dlgur1994/Purdue2019/README.md

# AgIoT_LoRa_vs_APRS
CIT 581 IoT Fall 2019

Semester project overview: Build a system to monitor a remote power generation station (solar and wind) and orchard for a “farmer” who lives 30 miles away.

Background: Agricultural IoT is one of the most promising and potentially important areas of the IoT market.  It is also an excellent way to study the IoT ecosystem while making important contributions to a field of research that is critical to our world; food and raw materials production.  Purdue’s CIT Department has had several successful projects in this area, and there are numerous companies and organizations in Central Indiana (such as WHIN) putting large amount of resources into Ag IoT systems.  

Project specifics: Our scenario will be that of a small orchard located about 30 miles from the “farmer”, who needs to monitor and receive pertinent data regarding fruit production, as well as monitoring the available alternative energy sources used to power irrigation, lighting and the IoT systems used for the project. The plan is to build an IoT system for a “Micro-Farm of the Future”.  Emphasis will be placed on the user interface and analytics that can quickly update the farmer on specific information that he needs to manage the farm and systems.  The specific sectors and topics that will be explored are as follows:
1.	Soil conditions:  The mainstay of farming, being able to get important information about moisture, temperature, pH, and other factors over a large geographic area is critical to successful yields.
2.	Weather information:  As important as soil conditions, weather information and outlook can make or break a year’s harvest.
3.	Alternative energy:  Many areas of agricultural land in the U.S. do not have easy access to electrical power.  An alternate power supply consisting of solar panels and a wind generator has already been built, but ways of monitoring key elements of the station for providing electrical power to irrigation, lighting as well as IoT and network equipment will need to be implemented.
4.	Radio Networks:  There are numerous LPWAN, as well as higher throughput networks (such as LTE), that we will need to evaluate and implement.  A parallel project with a group of students from the IITP sponsored program at the K-SW Square using the amateur radio (HAM) APRS frequencies as a no-cost network backbone will continue to be tested.
5.	Security:  Both Physical and Cyber Security systems must be considered. Of priority for the farmer is monitoring power and technology resources, implementing means of loss prevention, as well as pest and varmint detection and deterrence.

For Next Wednesday:
You are a small IoT integration company that is interested in completing the above described system for Farmer Smith, and if successful, possibly commercializing the system as a turn-key for other small farms. You have an interview with the customer Wednesday the 28th during the scheduled CIT 581 IoT class period.  What would you need to know if you were a vendor trying to put together a solution for this customer and have an acceptable ROI on the project?  Put together a list of questions to ask during the interview.

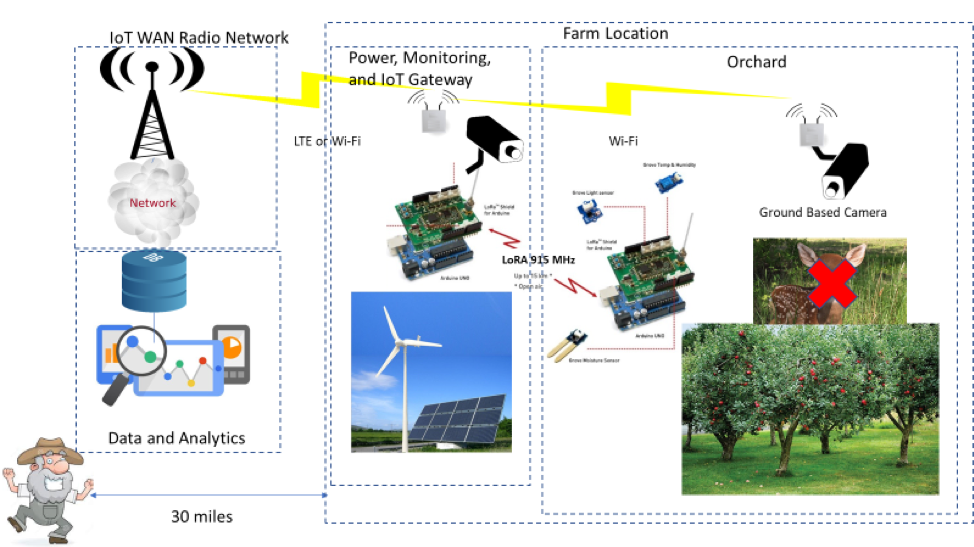
[picture p1: images/project_description.png]
ProjectDescription
