dlgur1994/Purdue2019/Records/Solenoid valve.docx

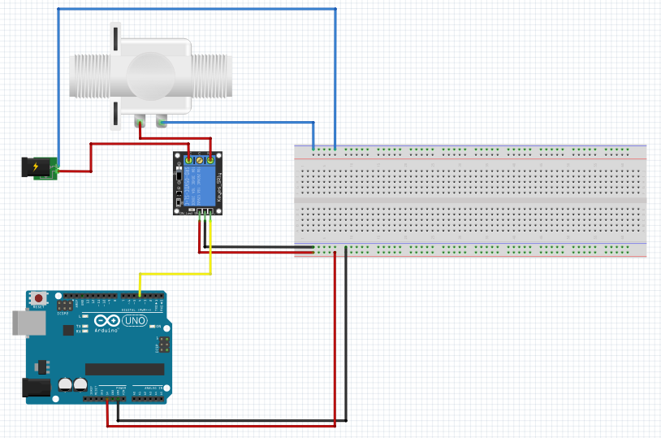
[picture p12: figure]

solenoid valve with external power supply
