dlgur1994/Purdue2019/LoRa/MQTT/LoRa_Web/LoRa Smart farm Web.docx

https://github.com/agiot2019-lora/lora-mqtt_smart_farm

여러분 저희 서비스 이름 멀로 할까여..? 그래도 이름은 있어야하지 않겠나..ㅎ

우선 Smart Farm 으로 둘게욤 -미란

Function:

1. Soil Moisture
2. Temperature
3. Humidity
4. Weather
5. Actuator Turn On/Off

DB structure

users(Farmer):

- user_id
- user_pw
- user_contact
- user_name

farms:

-farm_id

-farm_name

-farm_location

-user_id

soil_moisture:

-soil_moisture_id

- s_datetime
- soil_moisture
- farm_id

sensors:

-farm_id

- temperature
- weather
- Humidity
- Actuator (boolean true: on, false: off)
