dlgur1994/Purdue2019/Records/Papers/LoRa/Paper List.docx

1. “Smart Agriculture Solution using LoRa and IoT”

# 2. LoRa Based Smart Irrigation System

# 3. Smart Farm Monitoring Using LoRa Enabled IoT

# 4. A Practical Marine Wireless Sensor Network Monitoring System Based on LoRa and MQTT

5. Comparison of LoRa 915 MHz and 433 MHz on Distance Coverage in Thailand Area
