dlgur1994/Purdue2019/Records/Papers/Literature Review Matrix.xlsx

Authors | Title | Link | Year | Source title | Document Type
Kemal Hajdarevic, Samim Konjicija, Abdulhamit Subasi | A Low Energy APRS-IS Client-Server Infrastructure Implementation using Raspberry Pi | https://www.researchgate.net/publication/268100793_A_Low_Energy_APRS-IS_Client-Server_Infrastructure_Implementation_using_Raspberry_Pi | Nov. 2014 |  | PDF
Nayyar Anand, Puri Vikram | Smart farming: IoT based smart sensors agriculture stick for live temperature and moisture monitoring using Arduino, cloud computing & solar technology. | https://www.researchgate.net/publication/313804002_Smart_farming_IoT_based_smart_sensors_agriculture_stick_for_live_temperature_and_moisture_monitoring_using_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 | 2016 |  | PDF
