dlgur1994/Purdue2019/Forums/LoRa IoT Forums.docx

https://www.skyhook.com/blog/iot/internet-of-things-events

http://www.wikicfp.com/cfp/call?conference=internet%20of%20things

1. https://coinsconf.com/

(IEEE Coins, Barcelona Spain July 27-29 , Deadline: Mar 6, 2020)

Track Name: IoT-driven Smart Agriculture

A) Technologies, techniques and architectures

2. http://www.upiot.org/ (UPIOT, IEEE Shanghai)
3. https://iot-conference.org/iot2020/ (6-9 OCT 2020)
