dlgur1994/Purdue2019/Records/Run Top block.docx

파일 위치

~/yun/gr-APRS/Examples/top_block.py

이전 팀 최종 블럭

/home/sdr/yun/gr-APRS/Examples/APRS_RX_RTL
