dlgur1994/Purdue2019/Circuit/APRS_Arduino_circuit.PNG

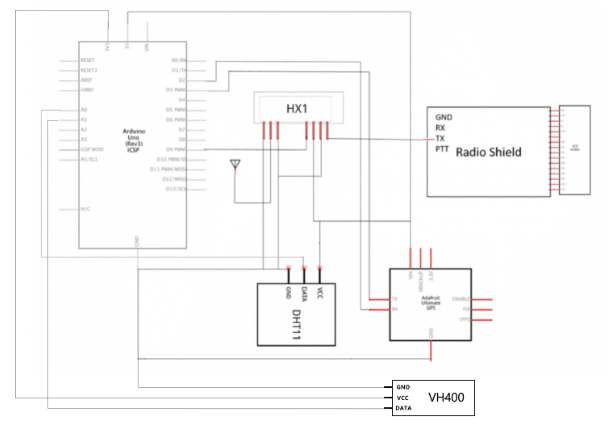
Circuit/APRS_Arduino_circuit.PNG
