dlgur1994/Purdue2019/LoRa/MQTT/LoRa_Sensor/써킷2.png

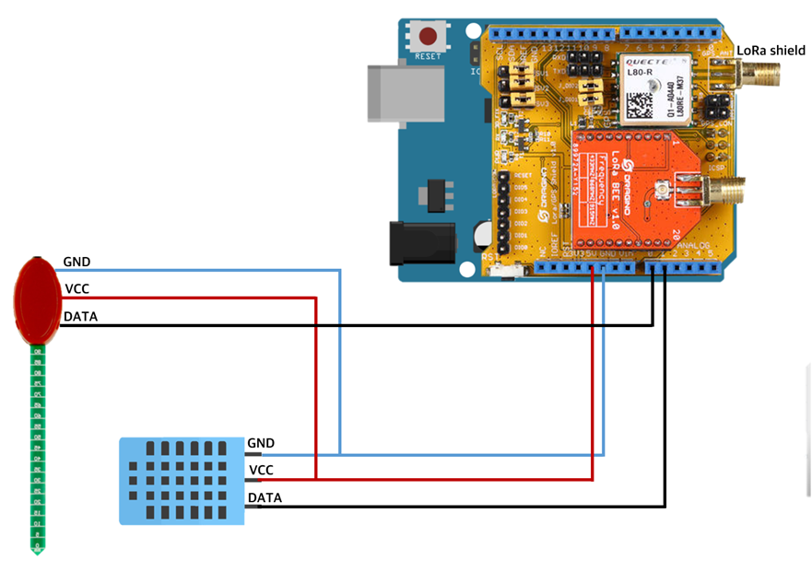
LoRa/MQTT/LoRa_Sensor/써킷2.png
