dlgur1994/Purdue2019/LoRa/MQTT/LoRa_Solenoid/solenoid_circit.png

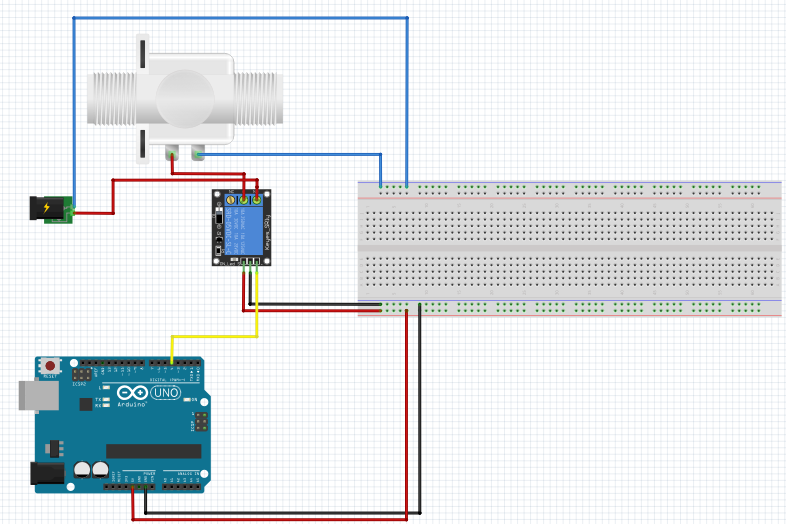
LoRa/MQTT/LoRa_Solenoid/solenoid_circit.png
