dlgur1994/Purdue2019/LoRa/MQTT/캡처.PNG

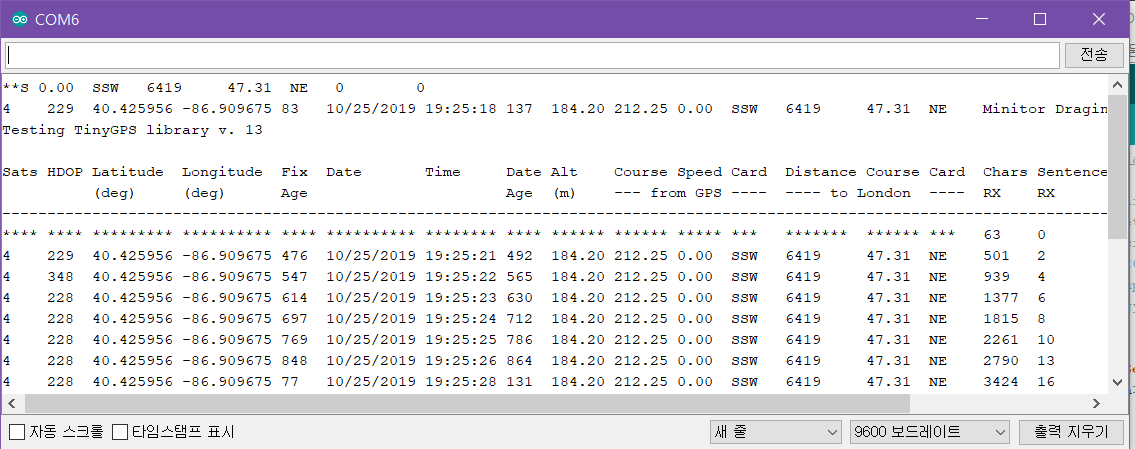
LoRa/MQTT/캡처.PNG
