dlgur1994/Purdue2019/Papers/LoRa/Flowchart-Page-3.png

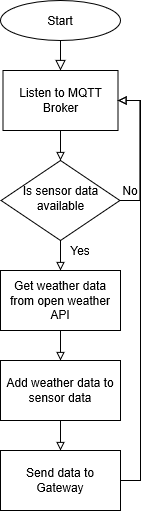
Papers/LoRa/Flowchart-Page-3.png
