dlgur1994/Purdue2019/Papers/LoRa/LoRa Diagram.png

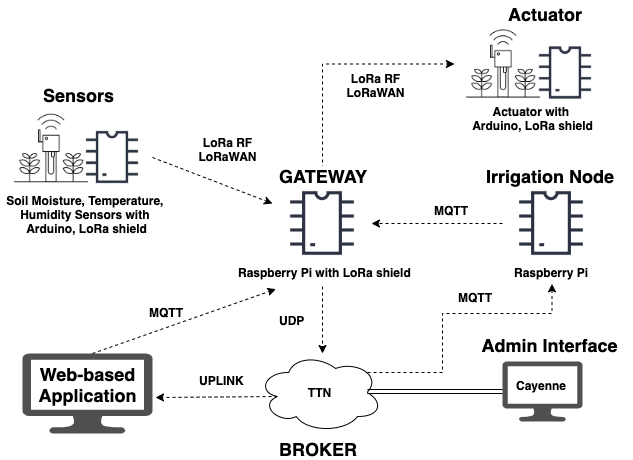
Papers/LoRa/LoRa Diagram.png
