dlgur1994/Purdue2019/Papers/LoRa vs APRS/making/비교논문 (2020-1 ver).docx

빨간 글씨 : 추가한 부분

빨간 공백 : 띄어쓰기 한 부분

빨간 취소선 : 글자 지운 부분 (괄호로 ‘00지운거’ 써놓음)

노란색 형광 : grammarly에서는 추가하라고 나오는데 확실치가 않은부분

파란색 형광 : grammarly에서 삭제 추천

초록색 형광 : grammarly에서 변경 추천

Title

Feasibility of Networking Technology for the Smart Farm : LoRa vs APRS

Abstract

Smart Farms and IoT (Internet of Things) have an inseparable relationship. Sensors, gateways, servers, databases, web-based applications, are all connected to smart farms. Hence, the decision of networking technology is very vital when running a smart farm. LoRa (Long Range) has been the most suggested candidate for smart farms. Theoretically, APRS (Automatic Packet Reporting System) can communicate far more distance than LoRa. However, there are no existing studies that implemented APRS in the smart farm IoT system. Therefore, this study tests and compares the distance coverage of LoRa and APRS networking technologies in the Purdue Agronomy Center for Research and Education. The results were evident that LoRa is more feasible than using APRS in the smart farm IoT system.

Introduction

With the fourth industrial revolution and the advancement of IoT technology, ICT (Information and Communication Technologies) has been integrated into agriculture and increased not only the quantity and quality of products but also convenience for the farmers. In IoT-based smart farming, data from weather conditions, light, soil moisture or crop’s growth progress is collected by IoT device sensors. With the data, farmers can monitor the field conditions from anywhere with smart devices. Also, irrigation systems are automated so that the water will be used more efficiently and the yields will be improved. In recent years, research on solutions to increase the performance and productivity of the smart farm while lowering the cost has become very popular. Previous studies like \cite{b1} show~~s~~(s지운거) that the main technologies of IoT based smart farming are network technologies, security, and IoT agriculture applications.

To be more specific with the networks, there are numerous network technologies for wireless connection of the sensors and actuators for IoT. The network technologies focus on providing scalability, extended coverage, low cost, and energy efficiency for the end-user devices \cite{b2}. Since the IoT agricultural network helps to monitor agriculture data and facilitate the transmission and reception of agriculture data, it is one of the vital elements of IoT in agriculture \cite{b1}.

Although many kinds of research~~es~~(es지운거) focus on implementing an IoT system with suitable communication network for smart farming, little attention has been given to comparing communication systems to decide the better network technology. Therefore, this study focuses on two network technologies, LoRa and APRS, for the smart farm IoT system. The objective of this paper is to question the feasibility of LoRa and APRS in the smart farm IoT system and to propose a better network technology that is more suitable for a smart farm. In this paper, we experiment with the distance coverage of the LoRa network and the APRS network at Purdue Agronomy Center for Research and Education.

Related work

This section discusses the existing IoT communication protocols, explaining why we particularly chose LoRa and APRS for this study.

LoRa

As this study focuses on IoT devices for smart farms, protocol selection was made within Low-Power Wide Area Networks (LPWANs). Two main factors should be considered when developing smart farm IoT devices: 1) wide area coverage; 2) long battery life. Therefore, short-range communication protocols like Bluetooth or ZigBee are not likely used for IoT devices that require long-range communication and wide area coverage. LPWAN, on the other hand, provides long-range connections with low data transmission rates\cite{b10}. Hence, LPWAN should be used for low power IoT devices that transmit a small amount of data and require battery efficiency\cite{b11}. Smart farm IoT devices suite these descriptions; comparatively small data collected by sensors transmitted for long-range communication.

LoRa, NB-IoT, Sigfox, Weightless are some of the leading LPWAN technologies. This study specifically tests LoRa as it is known to provide long-range communication, the long battery life on a low budget\cite{b12}. LoRa’s advantages are ~~evidently~~ shown in many studies. Ji et al.\cite{b13} successfully transmitted image data using LoRa technology. Kodali et al.\cite{b14} was (were) able to implement an irrigation system in a smart farm through a web interface.

APRS

Automatic Packet Reporting System (APRS), also known as ‘amateur radio’ or ‘ham radio’, was designed by Bob Bruninga about 25 years ago. APRS enables real-time information exchange between multiple nodes and processed data are visualized on APRS-Internet Service (APRS-IS) websites as the APRS infrastructure\cite{b15,b16}. APRS is transmitted on a shared local VHF frequency, depending on the country. North America uses 144.39 MHz. Although APRS was designed for large local areas, easy ~~digipeating~~~~(이런 단어가 없음)~~ repeating with callsigns allows fast global communications\cite{b17}. Due to these characteristics, APRS has been used for real-time tactical, emergent situations.

There are many attempts like Hajdarevic et al.\cite{b16} on building low-cost, low-energy APRS transceivers on microcontrollers or single-board computers such as Arduino and Raspberry Pi. Despite the increasing interest in building low-cost APRS transceivers and APRS' characteristics suitable for IoT devices, ~~there was no research that~~ ~~solely~~ ~~used~~ (no research solely used) or tested APRS as an IoT communication protocol. This raised the question of why APRS is not applied in the IoT field. Therefore, this study ultimately aims to answer the question of the feasibility of APRS for long-range IoT device communications.

Approach → trial and error 같은 느낌

여기 내용 추가

APRS 처음 셋업할때 이야기들…

- 우리가 값이 제대로 안나와서 간이 테스트를 하게 되었다.
- 제대로 실험하기 전에 했던 간이 테스트
  - transmit power를 높이는 방법
    - 얇은 케이블 -> 50옴 케이블
  - receive power를 높이는 방법
    - 안테나 접지
    - 안테나 높이
    - 안테나 방향 맞추기
- 이 결과 원하는 값이 나오게 되었고 이를 토대로 제대로 된 실험들을 진행하게 되었다.

Results

For the feasibility test of LoRa and APRS, we have conducted several tests outside at the Purdue Agronomy Center for Research and Education. This section mentions the test environments, multiple test results, and result evaluation for the distance coverage comparison of LoRa and APRS.

Test Environment

The distance comparison test between LoRa and APRS was conducted at the Purdue Agronomy Center for Research and Education. The tests were conducted by placing the receiving antenna at the weather station of the Purdue Agronomy Center. The receiving antenna of LoRa and the receiving antenna of APRS were installed on ~~a~~ (the) same bar, but ~~on~~ different height. The receiving antenna of LoRa was 4.0 meters high from the ground, 6.4 meters high for APRS. Transmitters were on the move, checking if the data were properly received at the receiving end, the weather station. Both transmitters ~~were~~ (was) carried in a car, and the antenna of APRS were securely attached to the roof of the car, while LoRa’s antenna was held at the same height as the transmitting antenna of APRS, 2.35 m. The location of the transmitting points were all saved on Google Maps, which was later used to calculate the distance from the weather station to the transmitter. To minimize radio interference during testing, LoRa and APRS were tested alternately. Also, cell phone calls were banned and at least 30 seconds of waiting time ~~was~~ (were) ensured to prevent possible errors due to the movement of the transmitters. If the data were consecutively received, the transmitters were moved forward for further distance. If not, the transmitters moved back to shorten the distance. This process was repeated to find the last transmitting point where data were successfully transmitted. All of the following distance results were derived by calculating the distance between the weather station and the last transmitting point using Google Maps.

Tests

Table 1 shows the overall distance coverage results from each test~~s~~(s지운거) while Table 1 and 2 shows the antenna specifications for LoRa and APRS.

1st test

The transmitter and receiver of LoRa consist of Arduino and LoRa Shield v1.4. The antenna gain for ~~the~~(the 지운거) both transmitting and receiving ends are 2.14 dBi. Both antennas were held by a hand on about 1 m above ground. The output power of the transmitter antenna measured by the spectrum analyzer was 16 dBm. Due to weather conditions, the receiver antenna was inside the weather station. The maximum distance coverage was 160 m.

<tables>

APRS used Arduino and HX1 transmitter while the antenna was connected using jumper cables. Software Defined Radio (SDR), powered by a laptop and an antenna was used as the receiver for APRS. The gain of the transmitter antenna for APRS was 2.14 dBi, where the output power was 15 dBm. For the receiver, the antenna gain was 6 dBi. At that time, the maximum distance was 1.3 km. Transmitting and receiving conditions were generally good, although some of the data were missed from time to time.

2nd test

LoRa changed both the transmitter and receiver antenna. Previously, the antenna gain for both antennas ~~were~~ (was) 2.14 dBi. With the new antennas, the transmitter antenna had 9 dBi gain and the receiver antenna had 6 dBi gain. The transmitter antenna was attached ~~on~~ (to) the car roof at about 1.8 meters above the ground. With the new antenna specifications, LoRa was able to cover 4.2 km, successfully receiving data.

For APRS, the setup for both sides ~~were~~ (was) the same as before, except for a transistor. A transistor was added to amplify the output power of the transmitter. While the transmitter antenna gain was identical to 2.14 dBi, the output power increased to 20 dBm by using the transistor. Two tests were conducted on this second test: 1) without transistor; 2) with the transistor. APRS covered 670 m without using the transistor, while it covered 700 m using the transistor. The result was significantly different ~~to~~ (from) the first test due to the open circuit problem inside the antenna.

Final test

To reduce the signal attenuation in the APRS circuit system, 50-ohm cable was used instead of the jumper cable to connect HX1 and the transmitter antenna.

<tables>

By doing so, the output signal from the HX1 got stronger, and the transmitting power measured by the spectrum analyzer was 24 dBm without the transistor. Since HX1 can handle signal power up to 24.7 dBm, the transistor was removed from the circuit. APRS also changed the transmitter antenna after the second test. The new transmitter antenna had 1.17 dBi gain. With the newly alternated APRS circuit and antenna, APRS was able to cover 0.86 km.

LoRa used identical specifications for the entire transmitter, receiver system. The results were also ~~identical~~ identified as the second test, covering 4.2 km as shown in Fig. 1.

Final setup

Table 3 lists all the hardware that ~~were~~ (was) used to build the transmitter and receiver system for LoRa and APRS.

LoRa

To facilitate the use of the LoRa network, LoRa/GPS shield attachable to the Arduino was used. The antennas used for both transmitter and receiver supported 915MHz, which is the LoRa frequency in North America. Transmitter antenna and receiver antenna had 9 dBi and 6 dBi gain. The output power of the transmit antenna measured by the spectrum analyzer was 16 dBm.

APRS

Arduino Uno and HX1 chip ~~was~~ (were) used to transmit APRS packets at 144.390MHz. Since the lack of a radio shield for APRS, HX1 was directly controlled to transmit power efficiently. The transmitter antenna was suitable for 144-148 MHz frequency, with 1.17 dBi gain. The transmitter antenna’s output power measured by the spectrum analyzer was 24 dBm. 50-ohm cable was used to connect the antenna and the HX1 transmitter to amplify the output power. To receive APRS data packets, GNU radio was used with USRP b200 on Ubuntu. The receiver antenna had 6 dBi gain.

Test evaluation

With the antenna specifications that were used for the final test, the Friis transmission formula was used to review the final distance coverage results:

<equations>

“The Friis Transmission formula is a basic equation used to calculate the received power of a basic receiver at a fixed distance from a transmitting system.”\cite{b18}

According to the Friis Transmission formula, theoretically, APRS should have covered a longer distance than LoRa as shown in Table 5. However, according to the final results, APRS distance was much shorter than LoRa. ~~In order to~~ (To) understand the reasoning of the final test results, the Fresnel Zone Radius was calculated.

The definition of Fresnel Zone is the size of the elliptically-shaped area of RF propagation between a transmit and receive antenna.

“Objects within the area of the Fresnel zone can reflect radio waves and induce multi-path propagation issues between the transmitter and receiver, where direct path line-of-sight radio waves and the reflected path radio waves are received out of phase from one another.” \cite{b19}

Therefore, ~~in order to~~ (to) have no interference, it is important to have no obstacles in the Fresnel Zone. This zone could be calculated by a Fresnel Zone Calculator:

<equations>

The antennas must be located within the 80\% of the radius obtained through the Fresnel Zone Calculator, shown in Table 5, for seamless communication.

The result of the Fresnel Zone Radius indicated that ~~in order to~~ (to)communicate around the theoretical 59.7 km, the theoretical distance, away using APRS, the antennas for both transceiver and receiver antenna must be at least 140m above the ground. However, the testing for the antennas ~~were~~ (was) installed approximately 4.0 m above the ground.

Additionally, ~~in order to~~ (to) calculate the efficiency constrained by height, the tested distance was divided by the theoretical distance. LoRa was 45.16\%, while APRS was 1.44\%, as shown in Table 5.

Conclusion

This study was proposed to determine whether LoRa or APRS is more adequate for the networking technology in Smart Farms. The location of the experiment for the distance coverage of both networks was at Purdue Agronomy Center for Research and Education. According to the test results, LoRa’s final distance coverage was 4.2 km, when the transmitter gain was 9 dBi and the receiver gain was 6 dBi. While APRS distance coverage was 0.84 km, with 1.17 dBi of transmitter gain and 6 dBi of receiver gain.

The efficiency constrained by height from the final test results was 45.16\% for LoRa and 1.44\% for APRS.

<table>

Both of the estimated antenna installation heights calculated from the Fresnel Zone Radius are high altitudes, which the majority of the smart farm system cannot meet the circumstances. When comparing the installation possibility of the two networking technologies, LoRa’s theoretical distance was more achievable than APRS. Therefore, the result indicates that LoRa is more feasible than APRS for ~~the~~ networking technology in smart farms.

However, there are limitations to our test experiment. First, the antenna specification was different for LoRa and APRS. Even though, we used two antennas that had the same dBi of 3, when running the frequency (APRS frequency) for the APRS the dBi was measured to be 1.17 dBi. Second, the testing was done after the corns were all harvested. Hence, there could be different results when there are obstacles between the transceiver and receiver antennas.

Future testing will be done by using the same antennas gains for LoRa and APRS. Also, the transmitter and receiver antennas will be installed at much higher altitudes.

References
