dlgur1994/Purdue2019/Papers/LoRa vs APRS/making/비교논문 (2020-3 ver).docx

빨간 글씨 : 추가한 부분

빨간 공백 : 띄어쓰기 한 부분

빨간 취소선 : 글자 지운 부분 (괄호로 ‘00지운거’ 써놓음)

노란색 형광 : grammarly에서는 추가하라고 나오는데 확실치가 않은부분

파란색 형광 : grammarly에서 삭제 추천

초록색 형광 : grammarly에서 변경 추천

Title

Feasibility of Networking Technology for Smart Farms: LoRa vs APRS

Abstract

Smart Farms and IoT (Internet of Things) have an inseparable relationship. Sensors, gateways, servers, databases, web-based applications, are all connected to smart farms. Hence, the decision of networking technology is very vital when running a smart farm. LoRa (Long Range) has been the most suggested candidate for smart farms. Theoretically, APRS (Automatic Packet Reporting System) can communicate far more distance than LoRa. However, there were no existing studies that implemented APRS in the smart farm IoT system. Therefore, this study tests and compares the distance coverage of LoRa and APRS networking technologies in the Purdue Agronomy Center for Research and Education. The results were evident that LoRa is more feasible than using APRS in the smart farm IoT system.

Introduction

With the fourth industrial revolution and the advancement of IoT technology, ICT (Information and Communication Technologies) has been integrated into agriculture and increased not only the quantity and quality of products but also convenience for the farmers. In IoT-based smart farming, data from weather conditions, light, soil moisture or crop’s growth progress is collected by IoT device sensors. With the data, farmers can monitor the field conditions from anywhere with smart devices. Also, irrigation systems are automated so that the water will be used more efficiently and the yields will be improved. In recent years, research on solutions to increase the performance and productivity of the smart farm while lowering the cost has become very popular. Previous studies like \cite{b1} show that the main technologies of IoT based smart farming are network technologies, security, and IoT agriculture applications.

To be more specific with the networks, there are numerous network technologies for wireless connection of the sensors and actuators for IoT. The network technologies focus on providing scalability, extended coverage, low cost, and energy efficiency for the end-user devices \cite{b2}. Since the IoT agricultural network helps to monitor agriculture data and facilitate the transmission and reception of agriculture data, it is one of the vital elements of IoT in agriculture \cite{b1}.

Although a lot of research focus on implementing an IoT system with a suitable communication network for smart farming, little attention has been given to comparing communication systems to decide the better network technology. Therefore, this study focuses on two network technologies, LoRa and APRS, for the smart farm IoT system. The objective of this paper is to question the feasibility of LoRa and APRS in the smart farm IoT system and to propose a better network technology that is more suitable for a smart farm. In this paper, we experiment the distance coverage of LoRa and APRS at the Purdue Agronomy Center for Research and Education.

Related work

This section discusses the existing IoT communication protocols, explaining why we particularly chose LoRa and APRS for this study.

LoRa

As this study focuses on IoT devices for smart farms, protocol selection was made within Low-Power Wide Area Networks (LPWANs). Two main factors should be considered when developing smart farm IoT devices: 1) wide area coverage; 2) long battery life. Therefore, short-range communication protocols like Bluetooth or ZigBee are not likely used for IoT devices that require long-range communication and wide area coverage. LPWAN, on the other hand, provides long-range connections with low data transmission rates\cite{b10}. Hence, LPWAN should be used for low power IoT devices that transmit a small amount of data and require battery efficiency\cite{b11}. Smart farm IoT devices suite these descriptions~~;~~ comparatively small data collected by sensors transmitted for long-range communication.

LoRa, NB-IoT, Sigfox, Weightless are some of the leading LPWAN technologies. This study specifically tests LoRa as it is known to provide long-range communication and long battery life on a low budget\cite{b12}. LoRa’s advantages are shown in many studies. Ji et al.\cite{b13} successfully transmitted image data using LoRa technology. Kodali et al.\cite{b14} implemented an irrigation system in a smart farm through a web interface.

APRS

Automatic Packet Reporting System (APRS), also known as ‘amateur radio’ or ‘ham radio’, was designed by Bob Bruninga about 25 years ago. APRS enables real-time information exchange between multiple nodes and processed data are visualized on APRS-Internet Service (APRS-IS) websites as the APRS infrastructure\cite{b15,b16}. APRS is transmitted on a shared local VHF frequency, depending on the country. North America uses 144.39 MHz. Although APRS was designed for large local areas, easy digital repeating with callsigns allows fast global communications\cite{b17}. Due to these characteristics, APRS has been used for real-time tactical, emergent situations.

There are many attempts like Hajdarevic et al.\cite{b16} on building low-cost, low-energy APRS transceivers on microcontrollers or single-board computers such as Arduino and Raspberry Pi. Despite the increasing interest in building low-cost APRS transceivers and APRS' characteristics suitable for IoT devices, there was no research that solely used or tested APRS as an IoT communication protocol. This raised the question of why APRS is not applied in the IoT field. Therefore, this study ultimately aims to answer the question of the feasibility of APRS for long-range IoT device communications.

Approach

At first, we didn't know the characteristics of the antenna properly, so we didn't get the results right and we did a lot of trials and some tests to get the results we wanted. (처음에 우리가 안테나의 특성을 제대로 알지 못하여 결과값이 제대로 안나왔고 원하는 결과값을 얻기 위한 많은 시도와 간이 테스트를 진행했다. )

Both LoRa and APRS had problems with too short a communication distance between the transmitter and the receiver. LoRa had a problem with the code, so after modifying LoRa's TX power to 13, signal bandwidth to 125E3, and coding rate to 5 using the LoRa Arduino API, the existing communication range increased from 100m to 1km. (LoRa와 APRS 둘 다 transmitter와 receiver의 통신 거리가 너무 짧은 문제가 있었다. LoRa는 코드에 문제가 있어서 LoRa Arduino API를 이용하여 LoRa의 TX power를 13, signal bandwidth를 125E3, 그리고 coding rate을 5로 수정을 하고 나니 기존의 통신거리 100m에서 1km까지 늘어났다.)

At first, we weren’t aware of the antenna’s characteristics, so the results were very different from our expectations. In order to minimize any errors, many attempts were made .

Both LoRa and APRS communication distance results were too short compared to theoretical results. After modifying LoRa’s transmitter and receiver code by LoRa’s TX power to 13, signal bandwidth to 125E3, and coding rate to 5 using LoRa Arduino API, the communication range results increased from 100m to 1km.

<로라 통신 거리 증가한 것 보여주는 비교 사진>

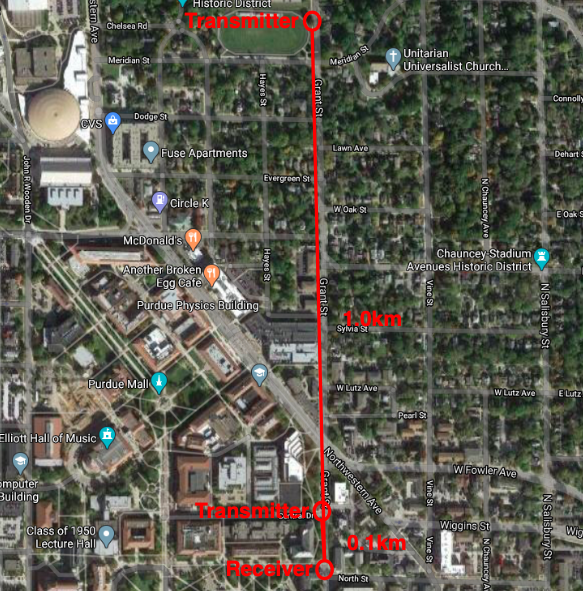
[picture p31: figure]

We recognized that the short communication distance at APRS was an antenna problem and we tested the antenna ground condition, the antenna height, and whether the two antennas were parallel. First of all, the antenna we used for APRS was magnetized at the bottom of the antenna, so grounding was important. Therefore, the antenna was attached to the metal part and the performance was improved. Also, knowing that the antenna should be kept high enough to carry it further, the receiver antenna was placed at a height of 4.5 meters, not at the floor level previously installed. We also learned that the two antennas should be in a parallel direction to better transmit the radio waves, so we always made the two antennas the same way. This increased the distance between the transmitter and the receiver from 50m to 890m. (In this test environment, the communication distance between the transmitter and the receiver could only be tested by about 890 m because the open space was up to about 890 m, and due to the terrain there was a height difference of about 10 m between the transmitter and the receiver.) Based on this, we understood the characteristics of the antenna and were able to conduct a proper later experiment while adjusting the parameters given above.

APRS는 짧은 통신 거리가 안테나 문제임을 인지하고 우리는 안테나 접지 상태, 안테나의 높이, 그리고 두 안테나의 평행 여부에 대해 테스트했다. 우선 우리가 APRS에 사용한 안테나는 안테나 아래 부분이 자석으로 되어 있어서 접지가 중요했다. 그래서 안테나를 쇠로 된 부분에 붙여서 실행을 진행했고 성능 개선을 볼 수 있었다. 그리고 안테나는 충분히 높은 곳에 두어야 더 멀리 전달된다는 것을 알고 transmitter 안테나를 기존에 설치해두던 바닥 높이가 아닌 차 지붕의 높이에 두고 receiver 안테나는 4.5m의 높이에 두었다. 또한 우리는 두 안테나가 평행한 방향으로 있어야 전파가 더욱 잘 전달된다는 것을 알게 되어 항상 두 안테나의 방향을 같게 해주었다. 이런한 것들 덕분에 transmitter와 receiver 사이의 통신 거리가 50 m 에서 890 m 로 증가하게 되었다 (간이 테스트 환경에서는 open space가 최대 890m이었기 때문에 그 이상 멀어질 수 없었고, 지형 때문에 transmitter와 receiver 사이에는 약 10m의 높이차가 있었다). 이를 토대로 안테나의 특성을 이해하게 되었고 위에 제시한 변수들을 조절하면서 제대로 된 실험을 진행할 수 있었다.

After realizing that there were problems with our APRS antenna, we tested the antenna’s ground condition, height, and whether the two antennas were in parallel. Since the antenna had a magnetized bottom, grounding was an crucial factor. Therefore, by attaching the antenna to an metal surface improved the performance.

Also, in order to increase the communication distance the antenna needed to be installed higher, so the placing of the receiver antenna was changed from the ground to 4.5meters above the surface. Moreover, to transmit radio waves efficiently the antennas needed to be installed in the same directions parallely. From these modifications, the communication distance increased from 50 m to 890m. Since the test environment was an open space environment and there was 10 m height difference between the transmitter and receiver antenna, 890m was the maximum result. Based on these attempts, we recognized the features of the antenna and were able to conduct proper experiments later on while adjusting the parameters given above.

<에비뉴 사우스 APRS 통신 거리 증가한 것 보여주는 비교 사진>

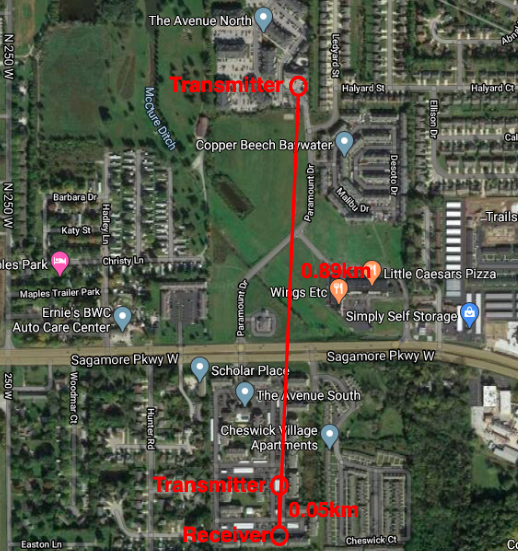
[picture p32: figure]

Also, because LoRa and APRS use different kinds of antennas, it was difficult to find antennas, which are the same gain, for the transmitter and the receiver respectively. So when we ignore the radio loss of cables and connectors, we experimented in a way to make LoRa's EIRP and APRS' EIRP equal: The sum of the gain of LoRa's transmitter antenna and LoRa's transmission power is as similar as possible to the sum of the gain of APRS’s transmitter antenna and APRS’s transmission power.

또한 우리는 LoRa와 APRS가 서로 다른 종류의 안테나를 사용하기 때문에 transmitter와 receiver를 위해 각각 같은 gain인 안테나를 구하기 어려웠다. 그래서 우리는 cable과 connector의 전파 loss를 무시했을 때 LoRa와 APRS의 EIRP를 같게 위한 방법, 즉 LoRa의 트랜스미터 안테나와 트랜스밋 파워의 합과 APRS의 트랜스미터 안테나와 트랜스밋 파워의 합을 최대한 갖게 하는 방향으로 실험을 진행했다.

Also, since LoRa and APRS used different kinds of antennas, it was difficult to find respective antennas for both the transmitter and receiver with the same gain. Thus, we experimented by making the sum of the gain of LoRa's transmitter antenna and LoRa's transmission power as similar to the sum of the gain of APRS’s transmitter antenna and APRS’s transmission power. This allowed LoRa and APRS EIRP to be equal when ignoring the radio loss of cables and connectors.

Results

For the feasibility test of LoRa and APRS, we have conducted several tests outside at the Purdue Agronomy Center for Research and Education. This section mentions the test environments, multiple test results, and result evaluation for the distance coverage comparison of LoRa and APRS.

Test Environment

The distance comparison test between LoRa and APRS was conducted at the Purdue Agronomy Center for Research and Education. The tests were conducted by placing the receiving antenna at the weather station of the Purdue Agronomy Center. The receiving antenna of LoRa and the receiving antenna of APRS were installed on the same bar but on different height. The receiving antenna of LoRa was 4.0 meters high from the ground, 6.4 meters high for APRS. Transmitters were on the move, checking if the data were properly received at the receiving end, the weather station. Both transmitters were carried in a car, and the antenna of APRS was securely attached to the roof of the car, while LoRa’s antenna was held at the same height as the transmitting antenna of APRS, 2.35 m. The location of the transmitting points were all saved on Google Maps, which was later used to calculate the distance from the weather station to the transmitter. To minimize radio interference during testing, LoRa and APRS were tested alternately. Also, cell phone calls were banned and at least 30 seconds of waiting time was ensured to prevent possible errors due to the movement of the transmitters. If the data were consecutively received, the transmitters were moved forward for further distance. If not, the transmitters moved back to shorten the distance. This process was repeated to find the last transmitting point where data were successfully transmitted. All of the following distance results were derived by calculating the distance between the weather station and the last transmitting point using Google Maps.

Tests

Table 1 shows the overall distance coverage results from each test while Table 1 and 2 shows the antenna specifications for LoRa and APRS.

1st test

The transmitter and receiver of LoRa consist of Arduino and LoRa Shield v1.4. The antenna gain for both transmitting and receiving ends are 2.14 dBi. Both antennas were held by hand on about 1 m above ground. The output power of the transmitter antenna measured by the spectrum analyzer was 16 dBm. Due to weather conditions, the receiver antenna was inside the weather station. The maximum distance coverage was 160 m.

<tables>

APRS used Arduino and HX1 transmitter while the antenna was connected using jumper cables. Software Defined Radio (SDR), powered by a laptop and an antenna was used as the receiver for APRS. The gain of the transmitter antenna for APRS was 2.14 dBi, where the output power was 15 dBm. For the receiver, the antenna gain was 6 dBi. At that time, the maximum distance was 1.3 km. Transmitting and receiving conditions were generally good, although some of the data were missed from time to time.

2nd test

LoRa changed both transmitter and receiver antenna. Previously, the antenna gain for both antennas was 2.14 dBi. With the new antennas, the transmitter antenna had 9 dBi gain and the receiver antenna had 6 dBi gain. The transmitter antenna was attached to the car roof at about 1.8 meters above the ground. With the new antenna specifications, LoRa was able to cover 4.2 km, successfully receiving data.

For APRS, the setup for both sides was the same as before, except for a transistor. A transistor was added to amplify the output power of the transmitter. While the transmitter antenna gain was identical to 2.14 dBi, the output power increased to 20 dBm by using the transistor. Two tests were conducted on this second test: 1) without transistor; 2) with the transistor. APRS covered 670 m without using the transistor, while it covered 700 m using the transistor. The result was significantly different from the first test due to the open circuit problem inside the antenna.

Final test

To reduce the signal attenuation in the APRS circuit system, 50-ohm cable was used instead of the jumper cable to connect HX1 and the transmitter antenna.

<tables>

By doing so, the output signal from the HX1 got stronger, and the transmitting power measured by the spectrum analyzer was 24 dBm without the transistor. Since HX1 can handle signal power up to 24.7 dBm, the transistor was removed from the circuit. APRS also changed the transmitter antenna after the second test. As APRS's transmission power went up, a new transmitter antenna was used to be most similar to LoRa's EIRP of 25dBm, which disregards the radio loss of the cables and the connectors. By changing the APRS's transmitter antenna, the APRS' EIRP, which disregards radio loss of the cables and the connectors became 25.17 dBm. (APRS의 트랜스밋 파워가 올라가면서 새로운 트랜스미터 안테나를 사용하게 되었는데 이는 cable과 connector의 전파 loss를 무시한 LoRa의 EIRP인 25dBm과 가장 비슷하게 하게 위함이다. APRS의 트랜스미터 안테나를 바꿈으로써 APRS의 EIRP는 25.17dBm이 되었다.)

As the transmission power of APRS increased, a new transmitter antenna with the APRS EIRP of 25.17dBM was used because it was most similar to LoRa’s EIRP of 25dBm, when disregarding the radio loss of the cables and connectors.

With the newly alternated APRS circuit and antenna, APRS was able to cover 0.86 km.

LoRa used identical specifications for the entire transmitter, receiver system. The results were also identical to the second test, covering 4.2 km as shown in Fig. 1.

Final setup

Table 3 lists all the hardware that were used to build the transmitter and receiver system for LoRa and APRS.

LoRa

To facilitate the use of LoRa network, LoRa/GPS shield attachable to the Arduino was used. The antennas used for both transmitter and receiver supported 915MHz, which is the LoRa frequency in North America. Transmitter antenna and receiver antenna had 9 dBi and 6 dBi gain. The output power of the transmit antenna measured by the spectrum analyzer was 16 dBm. Finally, LoRa's EIRP was 25 dBm, ignoring the radio loss of the cables and the connectors. (최종적으로 케이블과 커넥터의 전파 손실을 무시한 LoRa의 EIRP는 25dBm이었다.)

<LoRa receiver/transmitter 회로도>

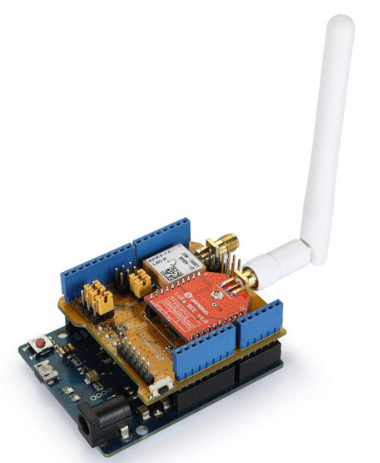
[picture p33: figure]

APRS

Arduino Uno and HX1 chip was used to transmit APRS packets at 144.390MHz. Since the lack of a radio shield for APRS, HX1 was directly controlled to transmit power efficiently. The transmitter antenna was suitable for 144-148 MHz frequency, with 1.17 dBi gain. The output power of the transmit antenna measured by the spectrum analyzer was 24 dBm. 50-ohm cable was used to connect the antenna and the HX1 transmitter to amplify the output power. To receive APRS data packets, GNU radio was used with USRP b200 on Ubuntu. The receiver antenna had 6 dBi gain. Finally, APRS's EIRP was 25.17 dBm, ignoring the radio loss of the cables and the connectors. (최종적으로 케이블과 커넥터의 전파 손실을 무시한 APRS의 EIRP는 25.17dBm이었다.)

<APRS receiver/transmitter 회로도>

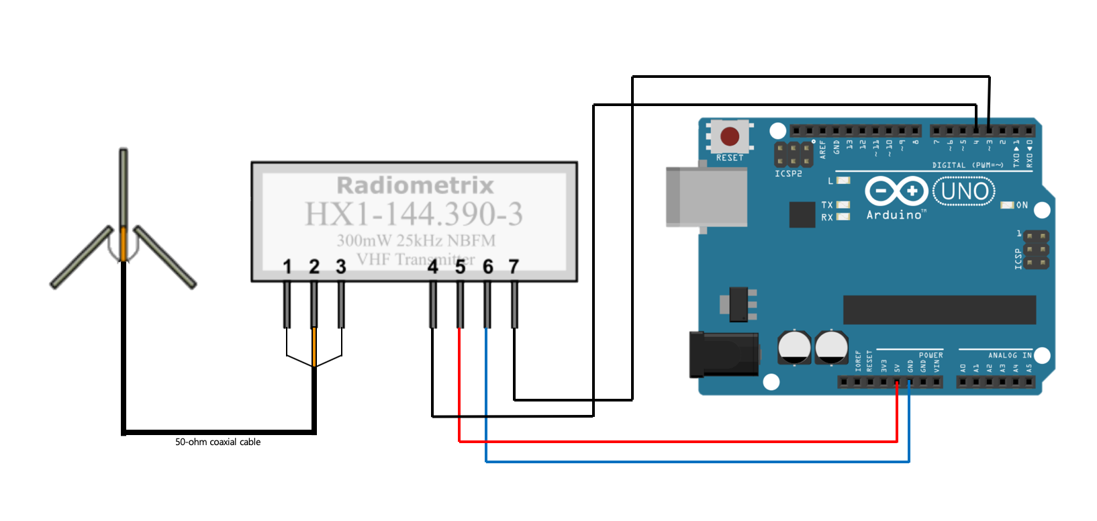
[picture p34: figure]
시계이(가) 표시된 사진 매우 높은 신뢰도로 생성된 설명
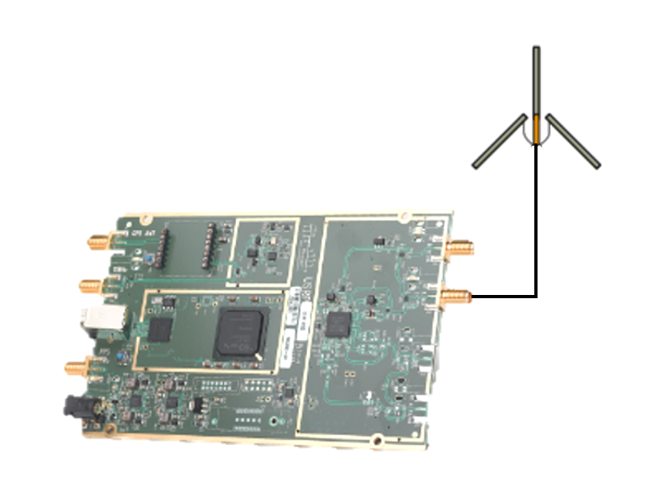
[picture p35: figure]

Test evaluation

With the antenna specifications that were used for the final test, the Friis transmission formula was used to review the final distance coverage results:

<equations>

“The Friis Transmission formula is a basic equation used to calculate the received power of a basic receiver at a fixed distance from a transmitting system.”\cite{b18}

According to the Friis Transmission formula, theoretically, APRS should have covered a longer distance than LoRa as shown in Table 5. However, according to the final results, APRS distance was much shorter than LoRa. To understand the reasoning of the final test results, the Fresnel Zone Radius was calculated.

The definition of Fresnel Zone is the size of the elliptically-shaped area of RF propagation between a transmit and receive antenna.

“Objects within the area of the Fresnel zone can reflect radio waves and induce multi-path propagation issues between the transmitter and receiver, where direct path line-of-sight radio waves and the reflected path radio waves are received out of phase from one another.” \cite{b19}

Therefore, to have no interference, it is important to have no obstacles in the Fresnel Zone. This zone could be calculated by a Fresnel Zone Calculator:

<equations>

The antennas must be located within the 80\% of the radius obtained through the Fresnel Zone Calculator, shown in Table 5, for seamless communication.

The result of the Fresnel Zone Radius indicated that to communicate around the theoretical 59.7 km, the theoretical distance, away using APRS, the antennas for both transceiver and receiver antenna must be at least 140m above the ground. However, the testing for the antennas was installed approximately 4.0 m above the ground.

Additionally, to calculate the efficiency constrained by height, the tested distance was divided by the theoretical distance. LoRa was 45.16\%, while APRS was 1.44\%, as shown in Table 5.

Conclusion

This study was proposed to determine whether LoRa or APRS is more adequate (or feasible) for the networking technology in Smart Farms. The location of the experiment for the distance coverage of both networks was at the Purdue Agronomy Center for Research and Education. According to the test results, LoRa’s final distance coverage was 4.2 km, when the transmitter gain was 9 dBi and the receiver gain was 6 dBi. While APRS distance coverage was 0.84 km, with 1.17 dBi of transmitter gain and 6 dBi of receiver gain.

The efficiency constrained by height from the final test results was 45.16\% for LoRa and 1.44\% for APRS.

<table>

Both of the estimated antenna installation heights calculated from the Fresnel Zone Radius are high altitudes, which the majority of the smart farm system cannot meet the circumstances. When comparing the installation possibility of the two networking technologies, LoRa’s theoretical distance was more achievable than APRS. Therefore, the result indicates that LoRa is more feasible than APRS for the networking technology in smart farms.

However, there are limitations to our test experiment. First, the antenna specification and the transmit power were different for LoRa and APRS. We tried to make LoRa's EIRP and APRS' EIRP the same, but the antenna gain and transmission power of LoRa and APRS were different. Second, the testing was done after the corns were all harvested. Hence, there could be different results when there are obstacles between the transceiver and receiver antennas.

Future tests will be performed by ensuring that LoRa and APRS have the same antenna gain and transmission power. Furthermore, the transmitter and receiver antennas will be installed at much higher altitudes.

References
