dlgur1994/Purdue2019/LoRa/Distance Test/LoRa_GPS/LoRa_GPS guide.docx

https://wiki.dragino.com/index.php?title=Lora/GPS_Shield
