dlgur1994/Purdue2019/Papers/LoRa vs APRS/making/LR-거리비교.xlsx

Sheet: IEEE
Authors | Title | PDF Link | 땅에서 재배하는 crop만? | smart farm system? (작물 기르는데 초점 맞춘) | if no, what is it about? | network 방식에 초점을 두었나? | Publication Title | Publication Year | Document Identifier
P. Serikul; N. Nakpong; N. Nakjuatong | Smart Farm Monitoring via the Blynk IoT Platform : Case Study: Humidity Monitoring and Data Recording | https://ieeexplore.ieee.org/stamp/stamp.jsp?arnumber=8612441 | ns | yes | ecosystem | ns | 2018 16th International Conference on ICT and Knowledge Engineering (ICT&KE) | 2018 | IEEE Conferences
M. H. Memon; W. Kumar; A. Memon; B. S. Chowdhry; M. Aamir; P. Kumar | Internet of Things (IoT) enabled smart animal farm | https://ieeexplore.ieee.org/stamp/stamp.jsp?arnumber=7724630 | no |  |  |  | 2016 3rd International Conference on Computing for Sustainable Global Development (INDIACom) | 2016 | IEEE Conferences
S. Puengsungwan; K. Jiraserccamomkul | IoT Based Stress Detection for Organic Lettuce Farms Using Chlorophyll Fluorescence (ChF) | https://ieeexplore.ieee.org/stamp/stamp.jsp?arnumber=8686651 | ns | ns | stress detection within plant's lifecycle | ns | 2018 Global Wireless Summit (GWS) | 2018 | IEEE Conferences
S. Jo; D. Park; H. Park; S. Kim | Smart Livestock Farms Using Digital Twin: Feasibility Study | https://ieeexplore.ieee.org/stamp/stamp.jsp?arnumber=8539516 | no |  |  |  | 2018 International Conference on Information and Communication Technology Convergence (ICTC) | 2018 | IEEE Conferences
Y. Mekonnen; L. Burton; A. Sarwat; S. Bhansali | IoT Sensor Network Approach for Smart Farming: An Application in Food, Energy and Water System | https://ieeexplore.ieee.org/stamp/stamp.jsp?arnumber=8601701 | ns | yes | automated irrigation system | ns | 2018 IEEE Global Humanitarian Technology Conference (GHTC) | 2018 | IEEE Conferences
R. Dagar; S. Som; S. K. Khatri | Smart Farming – IoT in Agriculture | https://ieeexplore.ieee.org/stamp/stamp.jsp?arnumber=8597264 | ns | yes | iot sensor package model | ns | 2018 International Conference on Inventive Research in Computing Applications (ICIRCA) | 2018 | IEEE Conferences
R. Varghese; S. Sharma | Affordable Smart Farming Using IoT and Machine Learning | https://ieeexplore.ieee.org/stamp/stamp.jsp?arnumber=8663044 | ns | yes | crop growth - iot and machine learning | ns | 2018 Second International Conference on Intelligent Computing and Control Systems (ICICCS) | 2018 | IEEE Conferences
M. M. Islam; S. Sourov Tonmoy; S. Quayum; A. R. Sarker; S. Umme Hani; M. A. Mannan | Smart Poultry Farm Incorporating GSM and IoT | https://ieeexplore.ieee.org/stamp/stamp.jsp?arnumber=8644300 | no |  |  |  | 2019 International Conference on Robotics,Electrical and Signal Processing Techniques (ICREST) | 2019 | IEEE Conferences
C. Yoon; M. Huh; S. Kang; J. Park; C. Lee | Implement smart farm with IoT technology | https://ieeexplore.ieee.org/stamp/stamp.jsp?arnumber=8323908 | ns | yes | low power bluetooth, lpwan, mqtt | yes | 2018 20th International Conference on Advanced Communication Technology (ICACT) | 2018 | IEEE Conferences
S. Koompairojn; C. Puitrakul; T. Bangkok; N. Riyagoon; S. Ruengittinun | Smart tag tracking for livestock farming | https://ieeexplore.ieee.org/stamp/stamp.jsp?arnumber=8074146 | no |  |  |  | 2017 10th International Conference on Ubi-media Computing and Workshops (Ubi-Media) | 2017 | IEEE Conferences
O. Chieochan; A. Saokaew; E. Boonchieng | Internet of things (IOT) for smart solar energy: A case study of the smart farm at Maejo University | https://ieeexplore.ieee.org/stamp/stamp.jsp?arnumber=8217588 | ns | yes | solar energy powering | ns | 2017 International Conference on Control, Automation and Information Sciences (ICCAIS) | 2017 | IEEE Conferences
M. S. Farooq; S. Riaz; A. Abid; K. Abid; M. A. Naeem | A Survey on the Role of IoT in Agriculture for the Implementation of Smart Farming | https://ieeexplore.ieee.org/stamp/stamp.jsp?arnumber=8883163 | ns | yes | agricultural iot 전반적 | ns | IEEE Access | 2019 | IEEE Journals
R. Perwiratama; Y. K. Setiadi; Suyoto | Smart hydroponic farming with IoT-based climate and nutrient manipulation system | https://ieeexplore.ieee.org/stamp/stamp.jsp?arnumber=8834533 | no |  |  |  | 2019 International Conference of Artificial Intelligence and Information Technology (ICAIIT) | 2019 | IEEE Conferences
Y. Kim; N. Lee; B. Kim; K. Shin | Realization of IoT Based Fish Farm Control Using Mobile App | https://ieeexplore.ieee.org/stamp/stamp.jsp?arnumber=8644854 | no |  |  |  | 2018 International Symposium on Computer, Consumer and Control (IS3C) | 2018 | IEEE Conferences
Amandeep; A. Bhattacharjee; P. Das; D. Basu; S. Roy; S. Ghosh; S. Saha; S. Pain; S. Dey; T. K. Rana | Smart farming using IOT | https://ieeexplore.ieee.org/stamp/stamp.jsp?arnumber=8117219 | ns | ns | controller? | ns | 2017 8th IEEE Annual Information Technology, Electronics and Mobile Communication Conference (IEMCON) | 2017 | IEEE Conferences
V. Gokul; S. Tadepalli | Implementation of smart infrastructure and non-invasive wearable for real time tracking and early identification of diseases in cattle farming using IoT | https://ieeexplore.ieee.org/stamp/stamp.jsp?arnumber=8058394 | no |  |  |  | 2017 International Conference on I-SMAC (IoT in Social, Mobile, Analytics and Cloud) (I-SMAC) | 2017 | IEEE Conferences
R. K. Kodali; S. Yerroju; S. Sahu | Smart Farm Monitoring Using LoRa Enabled IoT | https://ieeexplore.ieee.org/stamp/stamp.jsp?arnumber=8753086 | ns | yes | 우리랑 비슷 | ns | 2018 Second International Conference on Green Computing and Internet of Things (ICGCIoT) | 2018 | IEEE Conferences
E. Ariawan; A. Stanley Makalew | Smart Micro Farm: Sustainable Algae Spirulina Growth Monitoring System | https://ieeexplore.ieee.org/stamp/stamp.jsp?arnumber=8534904 | no |  |  |  | 2018 10th International Conference on Information Technology and Electrical Engineering (ICITEE) | 2018 | IEEE Conferences
A. Kamilaris; F. Gao; F. X. Prenafeta-Boldu; M. I. Ali | Agri-IoT: A semantic framework for Internet of Things-enabled smart farming applications | https://ieeexplore.ieee.org/stamp/stamp.jsp?arnumber=7845467 | ns | ns | semantic framework | ns | 2016 IEEE 3rd World Forum on Internet of Things (WF-IoT) | 2016 | IEEE Conferences
J. D. Stevens; T. Shaikh | MicroCEA: Developing a Personal Urban Smart Farming Device | https://ieeexplore.ieee.org/stamp/stamp.jsp?arnumber=8541311 | ns | ns | urban smart farming | ns | 2018 2nd International Conference on Smart Grid and Smart Cities (ICSGSC) | 2018 | IEEE Conferences
S. Suakanto; V. J. L. Engel; M. Hutagalung; D. Angela | Sensor networks data acquisition and task management for decision support of smart farming | https://ieeexplore.ieee.org/stamp/stamp.jsp?arnumber=7858233 | ns | yes | sesnor packet | ns | 2016 International Conference on Information Technology Systems and Innovation (ICITSI) | 2016 | IEEE Conferences
A. Thorat; S. Kumari; N. D. Valakunde | An IoT based smart solution for leaf disease detection | https://ieeexplore.ieee.org/stamp/stamp.jsp?arnumber=8336597 | ns | no | leaf disease | ns | 2017 International Conference on Big Data, IoT and Data Science (BID) | 2017 | IEEE Conferences
I. Mat; M. R. Mohd Kassim; A. N. Harun; I. M. Yusoff | Smart Agriculture Using Internet of Things | https://ieeexplore.ieee.org/stamp/stamp.jsp?arnumber=8632817 | ns | ns | sw and hw aspect of smart ag iot |  | 2018 IEEE Conference on Open Systems (ICOS) | 2018 | IEEE Conferences
K. Wongpatikaseree; P. Kanka; A. Ratikan | Developing Smart Farm and Traceability System for Agricultural Products using IoT Technology | https://ieeexplore.ieee.org/stamp/stamp.jsp?arnumber=8466479 | ns | no | no irrigation |  | 2018 IEEE/ACIS 17th International Conference on Computer and Information Science (ICIS) | 2018 | IEEE Conferences
A. A. Shakir; F. Hakim; M. Rasheduzzaman; S. Chakraborty; T. U. Ahmed; S. Hossain | Design and Implementation of SENSEP ACK: An IoT Based Mushroom Cultivation Monitoring System | https://ieeexplore.ieee.org/stamp/stamp.jsp?arnumber=8679183 | ns | ns | no irrigation system? |  | 2019 International Conference on Electrical, Computer and Communication Engineering (ECCE) | 2019 | IEEE Conferences
V. Puranik; Sharmila; A. Ranjan; A. Kumari | Automation in Agriculture and IoT | https://ieeexplore.ieee.org/stamp/stamp.jsp?arnumber=8777619 | ns | no | automation |  | 2019 4th International Conference on Internet of Things: Smart Innovation and Usages (IoT-SIU) | 2019 | IEEE Conferences
S. Verma; R. Gala; S. Madhavan; S. Burkule; S. Chauhan; C. Prakash | An Internet of Things (IoT) Architecture for Smart Agriculture | https://ieeexplore.ieee.org/stamp/stamp.jsp?arnumber=8697707 | ns | ns |  |  | 2018 Fourth International Conference on Computing Communication Control and Automation (ICCUBEA) | 2018 | IEEE Conferences
O. Chieochan; A. Saokaew; E. Boonchieng | IOT for smart farm: A case study of the Lingzhi mushroom farm at Maejo University | https://ieeexplore.ieee.org/stamp/stamp.jsp?arnumber=8025904 | ns | no |  |  | 2017 14th International Joint Conference on Computer Science and Software Engineering (JCSSE) | 2017 | IEEE Conferences
T. Wiangtong; P. Sirisuk | IoT-based Versatile Platform for Precision Farming | https://ieeexplore.ieee.org/stamp/stamp.jsp?arnumber=8587989 | ns | ns |  |  | 2018 18th International Symposium on Communications and Information Technologies (ISCIT) | 2018 | IEEE Conferences
V. P. Mishra; A. Chaudhry | The Role of Information and Communication Technologies in Architecture and Planning with Vertical Farming | https://ieeexplore.ieee.org/stamp/stamp.jsp?arnumber=8701292 | ns | no |  |  | 2019 Amity International Conference on Artificial Intelligence (AICAI) | 2019 | IEEE Conferences
M. M. Maha; S. Bhuiyan; M. Masuduzzaman | Smart Board for Precision Farming Using Wireless Sensor Network | https://ieeexplore.ieee.org/stamp/stamp.jsp?arnumber=8644215 | ns | ns |  |  | 2019 International Conference on Robotics,Electrical and Signal Processing Techniques (ICREST) | 2019 | IEEE Conferences
H. B. Biradar; L. Shabadi | Review on IOT based multidisciplinary models for smart farming | https://ieeexplore.ieee.org/stamp/stamp.jsp?arnumber=8256932 | ns | no |  |  | 2017 2nd IEEE International Conference on Recent Trends in Electronics, Information & Communication Technology (RTEICT) | 2017 | IEEE Conferences
R. G. Baldovino; I. C. Valenzuela; E. P. Dadios | Implementation of a Low-power Wireless Sensor Network for Smart Farm Applications | https://ieeexplore.ieee.org/stamp/stamp.jsp?arnumber=8666262 | ns | ns |  |  | 2018 IEEE 10th International Conference on Humanoid, Nanotechnology, Information Technology,Communication and Control, Environment and Management (HNICEM) | 2018 | IEEE Conferences
P. Sureephong; P. Wiangnak; S. Wicha | The comparison of soil sensors for integrated creation of IOT-based Wetting front detector (WFD) with an efficient irrigation system to support precision farming | https://ieeexplore.ieee.org/stamp/stamp.jsp?arnumber=7904949 | ns | ns |  |  | 2017 International Conference on Digital Arts, Media and Technology (ICDAMT) | 2017 | IEEE Conferences
S. R. Prathibha; A. Hongal; M. P. Jyothi | IOT Based Monitoring System in Smart Agriculture | https://ieeexplore.ieee.org/stamp/stamp.jsp?arnumber=8081906 | ns | ns |  |  | 2017 International Conference on Recent Advances in Electronics and Communication Technology (ICRAECT) | 2017 | IEEE Conferences
D. Saraswathi; P. Manibharathy; R. Gokulnath; E. Sureshkumar; K. Karthikeyan | Automation of Hydroponics Green House Farming using IOT | https://ieeexplore.ieee.org/stamp/stamp.jsp?arnumber=8541251 | no |  |  |  | 2018 ieee international conference on system, computation, automation and networking (icscan) | 2018 | IEEE Conferences
M. AshifuddinMondal; Z. Rehena | IoT Based Intelligent Agriculture Field Monitoring System | https://ieeexplore.ieee.org/stamp/stamp.jsp?arnumber=8442535 | ns | no |  |  | 2018 8th International Conference on Cloud Computing, Data Science & Engineering (Confluence) | 2018 | IEEE Conferences
C. Yoon; M. Huh; S. Kang; J. Park; C. Lee | Implement smart farm with IoT technology | https://ieeexplore.ieee.org/stamp/stamp.jsp?arnumber=8323907 | ns | ns |  |  | 2018 20th International Conference on Advanced Communication Technology (ICACT) | 2018 | IEEE Conferences
W. S. M. Sanjaya; S. Maryanti; C. Wardoyo; D. Anggraeni; M. A. Aziz; L. Marlina; A. Roziqin; A. Kusumorini | The development of quail eggs smart incubator for hatching system based on microcontroller and Internet of Things (IoT) | https://ieeexplore.ieee.org/stamp/stamp.jsp?arnumber=8350682 | no |  |  |  | 2018 International Conference on Information and Communications Technology (ICOIACT) | 2018 | IEEE Conferences
P. Dedeepya; U. S. A. Srinija; M. Gowtham Krishna; G. Sindhusha; T. Gnanesh | Smart Greenhouse Farming based on IOT | https://ieeexplore.ieee.org/stamp/stamp.jsp?arnumber=8474713 | ns | ns |  |  | 2018 Second International Conference on Electronics, Communication and Aerospace Technology (ICECA) | 2018 | IEEE Conferences
E. M. E. Ahmed; K. H. B. Abdalla; I. k. Eltahir | Farm Automation based on IoT | https://ieeexplore.ieee.org/stamp/stamp.jsp?arnumber=8515853 | ns | ns |  |  | 2018 International Conference on Computer, Control, Electrical, and Electronics Engineering (ICCCEEE) | 2018 | IEEE Conferences
N. Kalatzis; N. Marianos; F. Chatzipapadopoulos | IoT and data interoperability in agriculture: A case study on the gaiasenseTM smart farming solution | https://ieeexplore.ieee.org/stamp/stamp.jsp?arnumber=8766423 | ns | no |  |  | 2019 Global IoT Summit (GIoTS) | 2019 | IEEE Conferences
S. Ruengittinun; S. Phongsamsuan; P. Sureeratanakorn | Applied internet of thing for smart hydroponic farming ecosystem (HFE) | https://ieeexplore.ieee.org/stamp/stamp.jsp?arnumber=8074148 | no |  |  |  | 2017 10th International Conference on Ubi-media Computing and Workshops (Ubi-Media) | 2017 | IEEE Conferences
A. R. Ibrahim; N. H. N. Ibrahim; A. N. Harun; M. R. M. Kassim; S. E. Kamaruddin; G. Witjaksono | Bird Counting and Climate Monitoring using LoRaWAN in Swiftlet Farming for IR4.0 Applications | https://ieeexplore.ieee.org/stamp/stamp.jsp?arnumber=8535955 | no |  |  |  | 2018 2nd International Conference on Smart Sensors and Application (ICSSA) | 2018 | IEEE Conferences
J. Bauer; N. Aschenbruck | Design and implementation of an agricultural monitoring system for smart farming | https://ieeexplore.ieee.org/stamp/stamp.jsp?arnumber=8373022 | ns | ns |  |  | 2018 IoT Vertical and Topical Summit on Agriculture - Tuscany (IOT Tuscany) | 2018 | IEEE Conferences
T. Namgyel; S. Siyang; C. Khunarak; T. Pobkrut; J. Norbu; T. Chaiyasit; T. Kerdcharoen | IoT based hydroponic system with supplementary LED light for smart home farming of lettuce | https://ieeexplore.ieee.org/stamp/stamp.jsp?arnumber=8619983 | no | no |  |  | 2018 15th International Conference on Electrical Engineering/Electronics, Computer, Telecommunications and Information Technology (ECTI-CON) | 2018 | IEEE Conferences
K. Bounnady; P. Sibounnavong; K. Chanthavong; S. Saypadith | Smart Crop Cultivation Monitoring System by Using IoT | https://ieeexplore.ieee.org/stamp/stamp.jsp?arnumber=8802584 | ns | ns |  |  | 2019 5th International Conference on Engineering, Applied Sciences and Technology (ICEAST) | 2019 | IEEE Conferences
S. B. Saraf; D. H. Gawali | IoT based smart irrigation monitoring and controlling system | https://ieeexplore.ieee.org/stamp/stamp.jsp?arnumber=8256711 | ns | ns |  |  | 2017 2nd IEEE International Conference on Recent Trends in Electronics, Information & Communication Technology (RTEICT) | 2017 | IEEE Conferences
H. Shahinzadeh; J. Moradi; G. B. Gharehpetian; H. Nafisi; M. Abedi | IoT Architecture for Smart Grids | https://ieeexplore.ieee.org/stamp/stamp.jsp?arnumber=8641944 | ns | ns |  |  | 2019 International Conference on Protection and Automation of Power System (IPAPS) | 2019 | IEEE Conferences
F. C. L. Belista; M. P. C. Go; L. L. Luceñara; C. J. G. Policarpio; X. J. M. Tan; R. G. Baldovino | A Smart Aeroponic Tailored for IoT Vertical Agriculture using Network Connected Modular Environmental Chambers | https://ieeexplore.ieee.org/stamp/stamp.jsp?arnumber=8666382 | no |  |  |  | 2018 IEEE 10th International Conference on Humanoid, Nanotechnology, Information Technology,Communication and Control, Environment and Management (HNICEM) | 2018 | IEEE Conferences
N. Putjaika; S. Phusae; A. Chen-Im; P. Phunchongharn; K. Akkarajitsakul | A control system in an intelligent farming by using arduino technology | https://ieeexplore.ieee.org/stamp/stamp.jsp?arnumber=7519234 | ns | ns |  |  | 2016 Fifth ICT International Student Project Conference (ICT-ISPC) | 2016 | IEEE Conferences
S. J. Balakrishna; H. Marellapudi; N. Alivelu Manga | Iot Based Status Tracking and Controlling of Motor in Agricultural Farms | https://ieeexplore.ieee.org/stamp/stamp.jsp?arnumber=8596944 | ns | ns |  |  | 2018 5th IEEE Uttar Pradesh Section International Conference on Electrical, Electronics and Computer Engineering (UPCON) | 2018 | IEEE Conferences
M. Ryu; J. Yun; T. Miao; I. Ahn; S. Choi; J. Kim | Design and implementation of a connected farm for smart farming system | https://ieeexplore.ieee.org/stamp/stamp.jsp?arnumber=7370624 | ns | ns |  |  | 2015 IEEE SENSORS | 2015 | IEEE Conferences
N. Bakhtar; V. Chhabria; I. Chougle; H. Vidhrani; R. Hande | IoT based Hydroponic Farm | https://ieeexplore.ieee.org/stamp/stamp.jsp?arnumber=8748447 | no |  |  |  | 2018 International Conference on Smart Systems and Inventive Technology (ICSSIT) | 2018 | IEEE Conferences
A. Moon; J. Kim; J. Zhang; H. Liu; S. Woo Son | Understanding the impact of lossy compressions on IoT smart farm analytics | https://ieeexplore.ieee.org/stamp/stamp.jsp?arnumber=8258504 | ns | no |  |  | 2017 IEEE International Conference on Big Data (Big Data) | 2017 | IEEE Conferences
F. N. Sabri; N. H. H. M. Hanif; Z. Janin | Precision Crop Management for Indoor Farming | https://ieeexplore.ieee.org/stamp/stamp.jsp?arnumber=8688791 | ns | no |  |  | 2018 IEEE 5th International Conference on Smart Instrumentation, Measurement and Application (ICSIMA) | 2018 | IEEE Conferences
S. Vaishali; S. Suraj; G. Vignesh; S. Dhivya; S. Udhayakumar | Mobile integrated smart irrigation management and monitoring system using IOT | https://ieeexplore.ieee.org/stamp/stamp.jsp?arnumber=8286792 | ns | ns |  |  | 2017 International Conference on Communication and Signal Processing (ICCSP) | 2017 | IEEE Conferences
M. Bhagat; D. Kumar; D. Kumar | Role of Internet of Things (IoT) in Smart Farming: A Brief Survey | https://ieeexplore.ieee.org/stamp/stamp.jsp?arnumber=8783800 | ns | ns |  |  | 2019 Devices for Integrated Circuit (DevIC) | 2019 | IEEE Conferences
I. Haris; A. Fasching; L. Punzenberger; R. Grosu | CPS/IoT Ecosystem: Indoor Vertical Farming System | https://ieeexplore.ieee.org/stamp/stamp.jsp?arnumber=8900974 | ns | ns |  |  | 2019 IEEE 23rd International Symposium on Consumer Technologies (ISCT) | 2019 | IEEE Conferences
M. Hate; S. Jadhav; H. Patil | Vegetable Traceability with Smart Irrigation | https://ieeexplore.ieee.org/stamp/stamp.jsp?arnumber=8537253 | ns | ns |  |  | 2018 International Conference on Smart City and Emerging Technology (ICSCET) | 2018 | IEEE Conferences
S. K. Jain; A. Jain; A. Goswami; R. Purohit; A. S. Hari Haran Vinjarapu; S. Kumar Gawre | IoT based Smart Tea leaves Plucker with Two Revolute type Planar Manipulator | https://ieeexplore.ieee.org/stamp/stamp.jsp?arnumber=8546942 | ns | no |  |  | 2018 IEEE International Students' Conference on Electrical, Electronics and Computer Science (SCEECS) | 2018 | IEEE Conferences
L. Barreto; A. Amaral | Smart Farming: Cyber Security Challenges | https://ieeexplore.ieee.org/stamp/stamp.jsp?arnumber=8710531 | ns | no |  |  | 2018 International Conference on Intelligent Systems (IS) | 2018 | IEEE Conferences
V. Bojan; I. Raducu; F. Pop; M. Mocanu; V. Cristea | Cloud-based service for time series analysis and visualisation in Farm Management System | https://ieeexplore.ieee.org/stamp/stamp.jsp?arnumber=7312697 | ns | ns |  |  | 2015 IEEE International Conference on Intelligent Computer Communication and Processing (ICCP) | 2015 | IEEE Conferences
M. Taneja; J. Byabazaire; A. Davy; C. Olariu | Fog assisted application support for animal behaviour analysis and health monitoring in dairy farming | https://ieeexplore.ieee.org/stamp/stamp.jsp?arnumber=8355141 | no |  |  |  | 2018 IEEE 4th World Forum on Internet of Things (WF-IoT) | 2018 | IEEE Conferences
K. P. Satamraju; K. Shaik; N. Vellanki | RURAL BRIDGE: A novel system for smart and co-operative farming using IoT architecture | https://ieeexplore.ieee.org/stamp/stamp.jsp?arnumber=8363966 | ns | ns |  |  | 2017 International Conference on Multimedia, Signal Processing and Communication Technologies (IMPACT) | 2017 | IEEE Conferences
P. Padalalu; S. Mahajan; K. Dabir; S. Mitkar; D. Javale | Smart water dripping system for agriculture/farming | https://ieeexplore.ieee.org/stamp/stamp.jsp?arnumber=8226212 | ns | ns |  |  | 2017 2nd International Conference for Convergence in Technology (I2CT) | 2017 | IEEE Conferences
A. Bothe; J. Bauer; N. Aschenbruck | RFID-assisted Continuous User Authentication for IoT-based Smart Farming | https://ieeexplore.ieee.org/stamp/stamp.jsp?arnumber=8892140 | ns | no |  |  | 2019 IEEE International Conference on RFID Technology and Applications (RFID-TA) | 2019 | IEEE Conferences
L. Pan; M. Xu; L. Xi; Y. Hao | Research of livestock farming IoT system based on RESTful web services | https://ieeexplore.ieee.org/stamp/stamp.jsp?arnumber=8070130 | no |  |  |  | 2016 5th International Conference on Computer Science and Network Technology (ICCSNT) | 2016 | IEEE Conferences
C. Hsu; Y. Chiu; K. Wu; J. Liang; J. Chen; Y. Tseng | Design and Implementation of Image Electronic Fence with 5G technology for Smart Farms | https://ieeexplore.ieee.org/stamp/stamp.jsp?arnumber=8851659 | ns | no |  |  | 2019 IEEE VTS Asia Pacific Wireless Communications Symposium (APWCS) | 2019 | IEEE Conferences
R. Prabha; E. Sinitambirivoutin; F. Passelaigue; M. V. Ramesh | Design and Development of an IoT Based Smart Irrigation and Fertilization System for Chilli Farming | https://ieeexplore.ieee.org/stamp/stamp.jsp?arnumber=8538568 | ns | ns |  |  | 2018 International Conference on Wireless Communications, Signal Processing and Networking (WiSPNET) | 2018 | IEEE Conferences
M. Bacco; A. Berton; E. Ferro; C. Gennaro; A. Gotta; S. Matteoli; F. Paonessa; M. Ruggeri; G. Virone; A. Zanella | Smart farming: Opportunities, challenges and technology enablers | https://ieeexplore.ieee.org/stamp/stamp.jsp?arnumber=8373043 | ns | ns |  |  | 2018 IoT Vertical and Topical Summit on Agriculture - Tuscany (IOT Tuscany) | 2018 | IEEE Conferences
G. Suciu; C. Istrate; M. Diţu | Secure smart agriculture monitoring technique through isolation | https://ieeexplore.ieee.org/stamp/stamp.jsp?arnumber=8766433 | ns | no |  |  | 2019 Global IoT Summit (GIoTS) | 2019 | IEEE Conferences
V. Lohchab; M. Kumar; G. Suryan; V. Gautam; R. K. Das | A Review of IoT based Smart Farm Monitoring | https://ieeexplore.ieee.org/stamp/stamp.jsp?arnumber=8473337 | ns | ns |  |  | 2018 Second International Conference on Inventive Communication and Computational Technologies (ICICCT) | 2018 | IEEE Conferences
W. Vernandhes; N. S. Salahuddin; A. Kowanda; S. P. Sari | Smart aquaponic with monitoring and control system based on iot | https://ieeexplore.ieee.org/stamp/stamp.jsp?arnumber=8280590 | no |  |  |  | 2017 Second International Conference on Informatics and Computing (ICIC) | 2017 | IEEE Conferences
Y. Sukrismon; Aripriharta; N. Hidayatullah; N. Mufti; A. N. Handayani; G. J. Horng | Smart Fish Pond for Economic Growing in Catfish Farming | https://ieeexplore.ieee.org/stamp/stamp.jsp?arnumber=8921233 | no |  |  |  | 2019 International Conference on Computer Science, Information Technology, and Electrical Engineering (ICOMITEE) | 2019 | IEEE Conferences
S. N. Nnadi; F. E. Idachaba | Design and Implementation of a Sustainable IOT Enabled Greenhouse Prototype | https://ieeexplore.ieee.org/stamp/stamp.jsp?arnumber=8517006 | ns | ns |  |  | 2018 IEEE 5G World Forum (5GWF) | 2018 | IEEE Conferences
M. Dholu; K. A. Ghodinde | Internet of Things (IoT) for Precision Agriculture Application | https://ieeexplore.ieee.org/stamp/stamp.jsp?arnumber=8553720 | ns | ns |  |  | 2018 2nd International Conference on Trends in Electronics and Informatics (ICOEI) | 2018 | IEEE Conferences
A. Munandar; H. Fakhrurroja; I. F. A. Anto; R. P. Pratama; J. W. Wibowo; T. I. Salim; M. I. Rizqyawan | Design and development of an IoT-based smart hydroponic system | https://ieeexplore.ieee.org/stamp/stamp.jsp?arnumber=8864340 | no |  |  |  | 2018 International Seminar on Research of Information Technology and Intelligent Systems (ISRITI) | 2018 | IEEE Conferences
S. Pallavi; J. D. Mallapur; K. Y. Bendigeri | Remote sensing and controlling of greenhouse agriculture parameters based on IoT | https://ieeexplore.ieee.org/stamp/stamp.jsp?arnumber=8336571 | ns | ns |  |  | 2017 International Conference on Big Data, IoT and Data Science (BID) | 2017 | IEEE Conferences
S. Roy; R. Ray; A. Roy; S. Sinha; G. Mukherjee; S. Pyne; S. Mitra; S. Basu; S. Hazra | IoT, big data science & analytics, cloud computing and mobile app based hybrid system for smart agriculture | https://ieeexplore.ieee.org/stamp/stamp.jsp?arnumber=8079610 | ns | ns |  |  | 2017 8th Annual Industrial Automation and Electromechanical Engineering Conference (IEMECON) | 2017 | IEEE Conferences
Z. Mohammad; T. A. Qattam; K. Saleh | Security Weaknesses and Attacks on the Internet of Things Applications | https://ieeexplore.ieee.org/stamp/stamp.jsp?arnumber=8717411 | ns | no |  |  | 2019 IEEE Jordan International Joint Conference on Electrical Engineering and Information Technology (JEEIT) | 2019 | IEEE Conferences
A. Triantafyllou; D. C. Tsouros; P. Sarigiannidis; S. Bibi | An Architecture model for Smart Farming | https://ieeexplore.ieee.org/stamp/stamp.jsp?arnumber=8804834 | ns | no |  |  | 2019 15th International Conference on Distributed Computing in Sensor Systems (DCOSS) | 2019 | IEEE Conferences
N. Ahmed; D. De; I. Hussain | Internet of Things (IoT) for Smart Precision Agriculture and Farming in Rural Areas | https://ieeexplore.ieee.org/stamp/stamp.jsp?arnumber=8521668 | ns | ns |  |  | IEEE Internet of Things Journal | 2018 | IEEE Journals
A. Khandelwal; A. V. Singh; S. K. Khatri | Diverse IoT Based Gadgets to Update a Moderate Condition of Farmers in India | https://ieeexplore.ieee.org/stamp/stamp.jsp?arnumber=8701272 | ns | ns |  |  | 2019 Amity International Conference on Artificial Intelligence (AICAI) | 2019 | IEEE Conferences
J. Vaughan; P. M. Green; M. Salter; B. Grieve; K. B. Ozanyan | Floor sensors of animal weight and gait for precision livestock farming | https://ieeexplore.ieee.org/stamp/stamp.jsp?arnumber=8234202 | no |  |  |  | 2017 IEEE SENSORS | 2017 | IEEE Conferences
K. Soni; D. Waghela; R. Shah; M. Mohan | Smart Well Monitoring System | https://ieeexplore.ieee.org/stamp/stamp.jsp?arnumber=8537264 | no |  |  |  | 2018 International Conference on Smart City and Emerging Technology (ICSCET) | 2018 | IEEE Conferences
M. Wazid; A. K. Das; V. Odelu; N. Kumar; M. Conti; M. Jo | Design of Secure User Authenticated Key Management Protocol for Generic IoT Networks | https://ieeexplore.ieee.org/stamp/stamp.jsp?arnumber=8168328 | ns | no |  |  | IEEE Internet of Things Journal | 2018 | IEEE Journals
P. M. Gupta; M. Salpekar; P. K. Tejan | Agricultural practices Improvement Using IoT Enabled SMART Sensors | https://ieeexplore.ieee.org/stamp/stamp.jsp?arnumber=8537291 | ns | ns |  |  | 2018 International Conference on Smart City and Emerging Technology (ICSCET) | 2018 | IEEE Conferences
A. Ordoñez-García; M. Siller; O. Begovich | IoT architecture for urban agronomy and precision applications | https://ieeexplore.ieee.org/stamp/stamp.jsp?arnumber=8261582 | ns | ns |  |  | 2017 IEEE International Autumn Meeting on Power, Electronics and Computing (ROPEC) | 2017 | IEEE Conferences
S. Gong; A. Angani; K. J. Shin | Realization of Fluid Flow Control System for Vertical Recycling Aquatic System (VRAS) | https://ieeexplore.ieee.org/stamp/stamp.jsp?arnumber=8644824 | no |  |  |  | 2018 International Symposium on Computer, Consumer and Control (IS3C) | 2018 | IEEE Conferences
P. Rekha; V. P. Rangan; M. V. Ramesh; K. V. Nibi | High yield groundnut agronomy: An IoT based precision farming framework | https://ieeexplore.ieee.org/stamp/stamp.jsp?arnumber=8239287 | ns | ns |  |  | 2017 IEEE Global Humanitarian Technology Conference (GHTC) | 2017 | IEEE Conferences
I. Roussaki; P. Kosmides; G. Routis; K. Doolin; V. Pevtschin; A. Marguglio | A Multi-Actor Approach to promote the employment of IoT in Agriculture | https://ieeexplore.ieee.org/stamp/stamp.jsp?arnumber=8766416 | ns | ns |  |  | 2019 Global IoT Summit (GIoTS) | 2019 | IEEE Conferences
P. B. Sowmiya; B. K. Nagaswetha; D. Priyadharshini | Design of Automatic Nutrition Supply System Using IoT Technique in Modern Cities | https://ieeexplore.ieee.org/stamp/stamp.jsp?arnumber=8067587 | ns | ns |  |  | 2017 International Conference on Technical Advancements in Computers and Communications (ICTACC) | 2017 | IEEE Conferences
S. Sadowski; P. Spachos | Solar-Powered Smart Agricultural Monitoring System Using Internet of Things Devices | https://ieeexplore.ieee.org/stamp/stamp.jsp?arnumber=8614981 | ns | ns |  |  | 2018 IEEE 9th Annual Information Technology, Electronics and Mobile Communication Conference (IEMCON) | 2018 | IEEE Conferences
S. R. Rupanagudi; Ranjani B. S.; P. Nagaraj; V. G. Bhat; Thippeswamy G | A novel cloud computing based smart farming system for early detection of borer insects in tomatoes | https://ieeexplore.ieee.org/stamp/stamp.jsp?arnumber=7045722 | ns | no |  |  | 2015 International Conference on Communication, Information & Computing Technology (ICCICT) | 2015 | IEEE Conferences
C. Dupont; P. Cousin; S. Dupont | IoT for Aquaculture 4.0 Smart and easy-to-deploy real-time water monitoring with IoT | https://ieeexplore.ieee.org/stamp/stamp.jsp?arnumber=8534581 | no |  |  |  | 2018 Global Internet of Things Summit (GIoTS) | 2018 | IEEE Conferences
L. Lambrinos | Internet of Things in Agriculture: A Decision Support System for Precision Farming | https://ieeexplore.ieee.org/stamp/stamp.jsp?arnumber=8890447 | ns | ns |  |  | 2019 IEEE Intl Conf on Dependable, Autonomic and Secure Computing, Intl Conf on Pervasive Intelligence and Computing, Intl Conf on Cloud and Big Data Computing, Intl Conf on Cyber Science and Technology Congress (DASC/PiCom/CBDCom/CyberSciTech) | 2019 | IEEE Conferences
F. Balducci; D. Fomarelli; D. Impedovo; A. Longo; G. Pirlo | Smart Farms for a Sustainable and Optimized Model of Agriculture | https://ieeexplore.ieee.org/stamp/stamp.jsp?arnumber=8577226 | ns | ns |  |  | 2018 AEIT International Annual Conference | 2018 | IEEE Conferences
Y. Voutos; G. Drakopoulos; P. Mylonas | Smart Agriculture: An Open Field For Smart Contracts | https://ieeexplore.ieee.org/stamp/stamp.jsp?arnumber=8908411 | ns | no |  |  | 2019 4th South-East Europe Design Automation, Computer Engineering, Computer Networks and Social Media Conference (SEEDA-CECNSM) | 2019 | IEEE Conferences
S. Khummanee; S. Wiangsamut; P. Sorntepa; C. Jaiboon | Automated Smart Farming for Orchids with the Internet of Things and Fuzzy Logic | https://ieeexplore.ieee.org/stamp/stamp.jsp?arnumber=8584881 | no |  |  |  | 2018 International Conference on Information Technology (InCIT) | 2018 | IEEE Conferences
P. Srinivasulu; M. S. Babu; R. Venkat; K. Rajesh | Cloud service oriented architecture (CSoA) for agriculture through internet of things (IoT) and big data | https://ieeexplore.ieee.org/stamp/stamp.jsp?arnumber=8191906 | ns | ns |  |  | 2017 IEEE International Conference on Electrical, Instrumentation and Communication Engineering (ICEICE) | 2017 | IEEE Conferences
K. L. Krishna; O. Silver; W. F. Malende; K. Anuradha | Internet of Things application for implementation of smart agriculture system | https://ieeexplore.ieee.org/stamp/stamp.jsp?arnumber=8058236 | ns | ns |  |  | 2017 International Conference on I-SMAC (IoT in Social, Mobile, Analytics and Cloud) (I-SMAC) | 2017 | IEEE Conferences
M. H. Lashari; A. A. Memon; S. A. A. Shah; K. Nenwani; F. Shafqat | IoT Based Poultry Environment Monitoring System | https://ieeexplore.ieee.org/stamp/stamp.jsp?arnumber=8600837 | no |  |  |  | 2018 IEEE International Conference on Internet of Things and Intelligence System (IOTAIS) | 2018 | IEEE Conferences
S. B. M. S. S. Gunarathne; S. R. D. Kalingamudali | Smart Automation System for Controlling Various Appliances using a Mobile Device | https://ieeexplore.ieee.org/stamp/stamp.jsp?arnumber=8755104 | ns | ns |  |  | 2019 IEEE International Conference on Industrial Technology (ICIT) | 2019 | IEEE Conferences
D. M. Lofaro | The Honey Bee Initiative — Smart hive | https://ieeexplore.ieee.org/stamp/stamp.jsp?arnumber=7992772 | no |  |  |  | 2017 14th International Conference on Ubiquitous Robots and Ambient Intelligence (URAI) | 2017 | IEEE Conferences
M. H. Jumat; M. S. Nazmudeen; A. T. Wan | Smart farm prototype for plant disease detection, diagnosis & treatment using IoT device in a greenhouse | https://ieeexplore.ieee.org/stamp/stamp.jsp?arnumber=8726970 | ns | no |  |  | 7th Brunei International Conference on Engineering and Technology 2018 (BICET 2018) | 2018 | IET Conferences
J. Chopda; H. Raveshiya; S. Nakum; V. Nakrani | Cotton Crop Disease Detection using Decision Tree Classifier | https://ieeexplore.ieee.org/stamp/stamp.jsp?arnumber=8537336 | ns | no |  |  | 2018 International Conference on Smart City and Emerging Technology (ICSCET) | 2018 | IEEE Conferences
S. Saha; R. Hasan Rajib; S. Kabir | IoT Based Automated Fish Farm Aquaculture Monitoring System | https://ieeexplore.ieee.org/stamp/stamp.jsp?arnumber=8745543 | no |  |  |  | 2018 International Conference on Innovations in Science, Engineering and Technology (ICISET) | 2018 | IEEE Conferences
M. Ayaz; M. Ammad-Uddin; Z. Sharif; A. Mansour; E. M. Aggoune | Internet-of-Things (IoT)-Based Smart Agriculture: Toward Making the Fields Talk | https://ieeexplore.ieee.org/stamp/stamp.jsp?arnumber=8784034 | ns | ns |  |  | IEEE Access | 2019 | IEEE Journals
M. Sheth; P. Rupani | Smart Gardening Automation using IoT With BLYNK App | https://ieeexplore.ieee.org/stamp/stamp.jsp?arnumber=8862591 | ns | ns |  |  | 2019 3rd International Conference on Trends in Electronics and Informatics (ICOEI) | 2019 | IEEE Conferences
G. Suciu; T. Uşurelu; C. Beceanu; M. A. Dobrea | IoT and Energy Efficiency for Smart Agriculture using Adcon Telemetry Devices | https://ieeexplore.ieee.org/stamp/stamp.jsp?arnumber=8742433 | ns | ns |  |  | 2018 International Symposium on Fundamentals of Electrical Engineering (ISFEE) | 2018 | IEEE Conferences
A. Roy; A. Datta; J. Siddiquee; B. Poddar; B. Biswas; S. Saha; P. Sarkar | Energy-efficient Data Centers and smart temperature control system with IoT sensing | https://ieeexplore.ieee.org/stamp/stamp.jsp?arnumber=7746251 | ns | ns |  |  | 2016 IEEE 7th Annual Information Technology, Electronics and Mobile Communication Conference (IEMCON) | 2016 | IEEE Conferences
K. A. Sitaram; K. R. Ankush; K. N. Anant; B. R. Raghunath | IoT based Smart Management of Poultry Farm and Electricity Generation | https://ieeexplore.ieee.org/stamp/stamp.jsp?arnumber=8782308 | no |  |  |  | 2018 IEEE International Conference on Computational Intelligence and Computing Research (ICCIC) | 2018 | IEEE Conferences
A. Arena; A. Bianchini; P. Perazzo; C. Vallati; G. Dini | BRUSCHETTA: An IoT Blockchain-Based Framework for Certifying Extra Virgin Olive Oil Supply Chain | https://ieeexplore.ieee.org/stamp/stamp.jsp?arnumber=8784020 | ns | no |  |  | 2019 IEEE International Conference on Smart Computing (SMARTCOMP) | 2019 | IEEE Conferences
M. M. Elsokah; M. Sakah | Next Generation of Smart Aquaponics with Internet of Things Solutions | https://ieeexplore.ieee.org/stamp/stamp.jsp?arnumber=8717280 | no |  |  |  | 2019 19th International Conference on Sciences and Techniques of Automatic Control and Computer Engineering (STA) | 2019 | IEEE Conferences
S. Lee; H. Ahn; J. Seo; Y. Chung; D. Park; S. Pan | Practical Monitoring of Undergrown Pigs for IoT-based Large-Scale Smart Farm | https://ieeexplore.ieee.org/stamp/stamp.jsp?arnumber=8911419 | no |  |  |  | IEEE Access | 2019 | IEEE Early Access Articles
S. Salvi; S. A. Framed Jain; H. A. Sanjay; T. K. Harshita; M. Farhana; N. Jain; M. V. Suhas | Cloud based data analysis and monitoring of smart multi-level irrigation system using IoT | https://ieeexplore.ieee.org/stamp/stamp.jsp?arnumber=8058279 | ns | ns |  |  | 2017 International Conference on I-SMAC (IoT in Social, Mobile, Analytics and Cloud) (I-SMAC) | 2017 | IEEE Conferences
D. Davcev; K. Mitreski; S. Trajkovic; V. Nikolovski; N. Koteli | IoT agriculture system based on LoRaWAN | https://ieeexplore.ieee.org/stamp/stamp.jsp?arnumber=8402368 | ns | no | yes |  | 2018 14th IEEE International Workshop on Factory Communication Systems (WFCS) | 2018 | IEEE Conferences
U. Kulau; J. van Balen; S. Schildt; F. Büsching; L. Wolf | Dynamic sample rate adaptation for long-term IoT sensing applications | https://ieeexplore.ieee.org/stamp/stamp.jsp?arnumber=7845437 | ns | no |  |  | 2016 IEEE 3rd World Forum on Internet of Things (WF-IoT) | 2016 | IEEE Conferences
B. Yimwadsana; P. Chanthapeth; C. Lertthanyaphan; A. Pornvechamnuay | An IoT Controlled System for Plant Growth | https://ieeexplore.ieee.org/stamp/stamp.jsp?arnumber=8523886 | ns | ns |  |  | 2018 Seventh ICT International Student Project Conference (ICT-ISPC) | 2018 | IEEE Conferences
P. Suriyachai; J. Pansit | Effective Utilization of IoT for Low-cost Crop Monitoring and Automation | https://ieeexplore.ieee.org/stamp/stamp.jsp?arnumber=8713163 | ns | ns |  |  | 2018 21st International Symposium on Wireless Personal Multimedia Communications (WPMC) | 2018 | IEEE Conferences
T. M. C. Nguyen; D. B. Hoang | S-MANAGE Protocol For Software-Defined IoT | https://ieeexplore.ieee.org/stamp/stamp.jsp?arnumber=8615336 | ns | ns |  |  | 2018 28th International Telecommunication Networks and Applications Conference (ITNAC) | 2018 | IEEE Conferences
M. Kim; B. Hilton; Z. Burks; J. Reyes | Integrating Blockchain, Smart Contract-Tokens, and IoT to Design a Food Traceability Solution | https://ieeexplore.ieee.org/stamp/stamp.jsp?arnumber=8615007 | ns | no |  |  | 2018 IEEE 9th Annual Information Technology, Electronics and Mobile Communication Conference (IEMCON) | 2018 | IEEE Conferences
L. E. Nugroho; A. G. H. Pratama; I. W. Mustika; R. Ferdiana | Development of monitoring system for smart farming using Progressive Web App | https://ieeexplore.ieee.org/stamp/stamp.jsp?arnumber=8250513 | ns | ns |  |  | 2017 9th International Conference on Information Technology and Electrical Engineering (ICITEE) | 2017 | IEEE Conferences
C. Cambra; S. Sendra; J. Lloret; L. Garcia | An IoT service-oriented system for agriculture monitoring | https://ieeexplore.ieee.org/stamp/stamp.jsp?arnumber=7996640 | ns | ns |  |  | 2017 IEEE International Conference on Communications (ICC) | 2017 | IEEE Conferences
A. S. Spanias | Solar energy management as an Internet of Things (IoT) application | https://ieeexplore.ieee.org/stamp/stamp.jsp?arnumber=8316460 | ns | no |  |  | 2017 8th International Conference on Information, Intelligence, Systems & Applications (IISA) | 2017 | IEEE Conferences
B. Ashokkumar; M. A. Sriram; J. J. Michael; R. Ramakrishnan; S. S. Subramanian | Smart home development using relay circuit for rural environment | https://ieeexplore.ieee.org/stamp/stamp.jsp?arnumber=8261253 | ns | no |  |  | 2017 Third International Conference on Science Technology Engineering & Management (ICONSTEM) | 2017 | IEEE Conferences
Y. J. Jeong; K. E. An; S. W. Lee; D. Seo | Improved durability of soil humidity sensor for agricultural IoT environments | https://ieeexplore.ieee.org/stamp/stamp.jsp?arnumber=8326223 | ns | no |  |  | 2018 IEEE International Conference on Consumer Electronics (ICCE) | 2018 | IEEE Conferences
R. K. Kodali; V. Jain; S. Karagwal | IoT based smart greenhouse | https://ieeexplore.ieee.org/stamp/stamp.jsp?arnumber=7906846 | ns | ns |  |  | 2016 IEEE Region 10 Humanitarian Technology Conference (R10-HTC) | 2016 | IEEE Conferences
C. Pham; A. Rahim; P. Cousin | Low-cost, Long-range open IoT for smarter rural African villages | https://ieeexplore.ieee.org/stamp/stamp.jsp?arnumber=7580823 | ns | ns |  |  | 2016 IEEE International Smart Cities Conference (ISC2) | 2016 | IEEE Conferences
S. Solanke; P. Mehare; S. Shinde; V. Ingle; S. Zope | IoT Based Crop Disease Detection and Pesting for Greenhouse - A Review | https://ieeexplore.ieee.org/stamp/stamp.jsp?arnumber=8529156 | ns | no |  |  | 2018 3rd International Conference for Convergence in Technology (I2CT) | 2018 | IEEE Conferences
P. C. P. De Silva; P. C. A. De Silva | Ipanera: An Industry 4.0 based architecture for distributed soil-less food production systems | https://ieeexplore.ieee.org/stamp/stamp.jsp?arnumber=7780266 | no |  |  |  | 2016 Manufacturing & Industrial Engineering Symposium (MIES) | 2016 | IEEE Conferences
V. K. Sarker; J. P. Queralta; T. N. Gia; H. Tenhunen; T. Westerlund | A Survey on LoRa for IoT: Integrating Edge Computing | https://ieeexplore.ieee.org/stamp/stamp.jsp?arnumber=8795313 | ns | ns |  |  | 2019 Fourth International Conference on Fog and Mobile Edge Computing (FMEC) | 2019 | IEEE Conferences
U. Acar; F. Kane; P. Vlacheas; V. Foteinos; P. Demestichas; G. Yücetürk; I. Drigkopoulou; A. Vargün | Designing An IoT Cloud Solution for Aquaculture | https://ieeexplore.ieee.org/stamp/stamp.jsp?arnumber=8766428 | no |  |  |  | 2019 Global IoT Summit (GIoTS) | 2019 | IEEE Conferences
A. T. Abagissa; A. Behura; S. K. Pani | IoT Based Smart Agricultural Device Controlling System | https://ieeexplore.ieee.org/stamp/stamp.jsp?arnumber=8473126 | ns | ns |  |  | 2018 Second International Conference on Inventive Communication and Computational Technologies (ICICCT) | 2018 | IEEE Conferences
L. Wan; Z. Zhang; Y. Huang; Y. Yan; J. Wang | Performance Analysis of NB-IoT Technology for Indoor IoT Applications | https://ieeexplore.ieee.org/stamp/stamp.jsp?arnumber=8789064 | ns | no |  |  | 2017 International Conference on Computer Technology, Electronics and Communication (ICCTEC) | 2017 | IEEE Conferences
T. Nguyen; L. Lê; H. Truong; K. Nguyen-An; P. Hoai Ha | Handling Service Level Agreements in IoT = Minding Rules + Log Analytics? | https://ieeexplore.ieee.org/stamp/stamp.jsp?arnumber=8536158 | ns | no |  |  | 2018 IEEE 22nd International Enterprise Distributed Object Computing Conference (EDOC) | 2018 | IEEE Conferences
H. A. M. Tran; H. Q. T. Ngo; T. P. Nguyen; H. Nguyen | Design of Green Agriculture System Using Internet of Things and Image Processing Techniques | https://ieeexplore.ieee.org/stamp/stamp.jsp?arnumber=8595663 | ns | ns |  |  | 2018 4th International Conference on Green Technology and Sustainable Development (GTSD) | 2018 | IEEE Conferences
L. Ramundo; M. Taisch; S. Terzi | State of the art of technology in the food sector value chain towards the IoT | https://ieeexplore.ieee.org/stamp/stamp.jsp?arnumber=7740612 | ns | no |  |  | 2016 IEEE 2nd International Forum on Research and Technologies for Society and Industry Leveraging a better tomorrow (RTSI) | 2016 | IEEE Conferences
S. Pooja; D. V. Uday; U. B. Nagesh; S. G. Talekar | Application of MQTT protocol for real time weather monitoring and precision farming | https://ieeexplore.ieee.org/stamp/stamp.jsp?arnumber=8284616 | ns | ns |  |  | 2017 International Conference on Electrical, Electronics, Communication, Computer, and Optimization Techniques (ICEECCOT) | 2017 | IEEE Conferences
R. K. Kodali; K. P. Nimmanapalli; S. Jyothirmay | Micro:Bit Based IRRIGATION MONITORING | https://ieeexplore.ieee.org/stamp/stamp.jsp?arnumber=8777721 | ns | ns |  |  | 2018 4th International Conference on Computing Communication and Automation (ICCCA) | 2018 | IEEE Conferences
S. Jaiganesh; K. Gunaseelan; V. Ellappan | IOT agriculture to improve food and farming technology | https://ieeexplore.ieee.org/stamp/stamp.jsp?arnumber=8073690 | ns | ns |  |  | 2017 Conference on Emerging Devices and Smart Systems (ICEDSS) | 2017 | IEEE Conferences
M. Ammad Uddin; M. Ayaz; E. M. Aggoune; A. Mansour; D. Le Jeune | Affordable Broad Agile Farming System for Rural and Remote Area | https://ieeexplore.ieee.org/stamp/stamp.jsp?arnumber=8815723 | ns | ns |  |  | IEEE Access | 2019 | IEEE Journals
A. Moon; J. Kim; J. Zhang; S. W. Son | Lossy compression on IoT big data by exploiting spatiotemporal correlation | https://ieeexplore.ieee.org/stamp/stamp.jsp?arnumber=8091030 | ns | no |  |  | 2017 IEEE High Performance Extreme Computing Conference (HPEC) | 2017 | IEEE Conferences
M. Lee; H. Kim; H. Yoe | Intelligent environment management system for controlled horticulture | https://ieeexplore.ieee.org/stamp/stamp.jsp?arnumber=8108049 | ns | ns |  |  | 2017 4th NAFOSTED Conference on Information and Computer Science | 2017 | IEEE Conferences
A. Na; W. Isaac | Developing a human-centric agricultural model in the IoT environment | https://ieeexplore.ieee.org/stamp/stamp.jsp?arnumber=7562740 | ns | ns |  |  | 2016 International Conference on Internet of Things and Applications (IOTA) | 2016 | IEEE Conferences
R. Patgiri; S. Nayak | Data of Things: The Best Things Since Sliced Bread | https://ieeexplore.ieee.org/stamp/stamp.jsp?arnumber=8524588 | ns | no |  |  | 2018 International Conference on Communication and Signal Processing (ICCSP) | 2018 | IEEE Conferences
A. R. Roselin; A. Jawahar | Smart agro system using wireless sensor networks | https://ieeexplore.ieee.org/stamp/stamp.jsp?arnumber=8250751 | ns | ns |  |  | 2017 International Conference on Intelligent Computing and Control Systems (ICICCS) | 2017 | IEEE Conferences
P. Corista; D. Ferreira; J. Gião; J. Sarraipa; R. J. Gonçalves | An IoT Agriculture System Using FIWARE | https://ieeexplore.ieee.org/stamp/stamp.jsp?arnumber=8436381 | ns | ns |  |  | 2018 IEEE International Conference on Engineering, Technology and Innovation (ICE/ITMC) | 2018 | IEEE Conferences
C. Hirsch; E. Bartocci; R. Grosu | Capacitive Soil Moisture Sensor Node for IoT in Agriculture and Home | https://ieeexplore.ieee.org/stamp/stamp.jsp?arnumber=8901012 | ns | ns |  |  | 2019 IEEE 23rd International Symposium on Consumer Technologies (ISCT) | 2019 | IEEE Conferences
R. Nukala; K. Panduru; A. Shields; D. Riordan; P. Doody; J. Walsh | Internet of Things: A review from ‘Farm to Fork’ | https://ieeexplore.ieee.org/stamp/stamp.jsp?arnumber=7528456 | ns | no |  |  | 2016 27th Irish Signals and Systems Conference (ISSC) | 2016 | IEEE Conferences
R. K. Kodali; M. S. Kuthada; Y. K. Yogi Borra | LoRa Based Smart Irrigation System | https://ieeexplore.ieee.org/stamp/stamp.jsp?arnumber=8777583 | ns | ns |  |  | 2018 4th International Conference on Computing Communication and Automation (ICCCA) | 2018 | IEEE Conferences
D. K. Sreekantha; Kavya A.M. | Agricultural crop monitoring using IOT - a study | https://ieeexplore.ieee.org/stamp/stamp.jsp?arnumber=7855968 | ns | ns |  |  | 2017 11th International Conference on Intelligent Systems and Control (ISCO) | 2017 | IEEE Conferences
S. Thakare; P. H. Bhagat | Arduino-Based Smart Irrigation Using Sensors and ESP8266 WiFi Module | https://ieeexplore.ieee.org/stamp/stamp.jsp?arnumber=8663041 | ns | ns |  |  | 2018 Second International Conference on Intelligent Computing and Control Systems (ICICCS) | 2018 | IEEE Conferences
A. R. Chaudhry; V. P. Mishra | A Comparative Analysis of Vertical Agriculture Systems in Residential Apartments | https://ieeexplore.ieee.org/stamp/stamp.jsp?arnumber=8714358 | ns | no |  |  | 2019 Advances in Science and Engineering Technology International Conferences (ASET) | 2019 | IEEE Conferences
T. Okayasu; A. P. Nugroho; A. Sakai; D. Arita; T. Yoshinaga; R. Taniguchi; M. Horimoto; E. Inoue; Y. Hirai; M. Mitsuoka | Affordable field environmental monitoring and plant growth measurement system for smart agriculture | https://ieeexplore.ieee.org/stamp/stamp.jsp?arnumber=8304486 | ns | ns |  |  | 2017 Eleventh International Conference on Sensing Technology (ICST) | 2017 | IEEE Conferences
S. Kumar; P. Raja; G. Bhargavi | A Comparative Study on Modern Smart Irrigation System and Monitoring the Field by using IOT | https://ieeexplore.ieee.org/stamp/stamp.jsp?arnumber=8675026 | ns | ns |  |  | 2018 International Conference on Computing, Power and Communication Technologies (GUCON) | 2018 | IEEE Conferences
K. K. Kumar; S. Rachamalla; S. V. Laxmi; P. Sindhu | Most Economical - IOT based SmartIrrigation Using GSM | https://ieeexplore.ieee.org/stamp/stamp.jsp?arnumber=8724029 | ns | ns |  |  | 2018 3rd International Conference on Communication and Electronics Systems (ICCES) | 2018 | IEEE Conferences
S. Y. Kim; H. Kim; B. Y. Kim; C. K. Kim; Y. H. Kang; G. S. Jang | Ramp Characteristics of Photovoltaic and Wind Power in South Korea | https://ieeexplore.ieee.org/stamp/stamp.jsp?arnumber=8908000 | ns | no |  |  | 2019 IEEE 16th International Conference on Smart Cities: Improving Quality of Life Using ICT & IoT and AI (HONET-ICT) | 2019 | IEEE Conferences
K. T. E. Keerthana; S. Karpagavalli; A. M. Posonia | Smart System Monitoring Agricultural Land Using Iot | https://ieeexplore.ieee.org/stamp/stamp.jsp?arnumber=8529037 | ns | ns |  |  | 2018 International Conference on Emerging Trends and Innovations In Engineering And Technological Research (ICETIETR) | 2018 | IEEE Conferences
M. M. Neto; E. F. Coutinho; L. O. Moreira; J. N. de Souza; N. Agoulmine | A Proposal for Monitoring People of Health Risk Group Using IoT Technologies | https://ieeexplore.ieee.org/stamp/stamp.jsp?arnumber=8531196 | no |  |  |  | 2018 IEEE 20th International Conference on e-Health Networking, Applications and Services (Healthcom) | 2018 | IEEE Conferences
M. I. Alipio; A. E. M. Dela Cruz; J. D. A. Doria; R. M. S. Fruto | A smart hydroponics farming system using exact inference in Bayesian network | https://ieeexplore.ieee.org/stamp/stamp.jsp?arnumber=8229470 | no |  |  |  | 2017 IEEE 6th Global Conference on Consumer Electronics (GCCE) | 2017 | IEEE Conferences
A. D. Boursianis; M. S. Papadopoulou; P. Damantoulakis; A. Karampatea; P. Doanis; D. Geourgoulas; A. Skoufa; D. Valavanis; C. Apostolidis; D. G. Babas; K. B. Baltzis; T. N. Kaifas; K. Siozios; S. Siskos; T. Samaras; K. Siakavara; S. Nikolaidis; S. K. Goudos; A. Liopa-Tsakalidi; P. Barouchas; I. Kasimis; G. Kalamaras; D. Merkouris; G. Perrakis; C. Tsirogiannis; A. Gotsis; K. Maliatsos | Advancing Rational Exploitation of Water Irrigation Using 5G-IoT Capabilities: The AREThOU5A Project | https://ieeexplore.ieee.org/stamp/stamp.jsp?arnumber=8862146 | ns | ns |  |  | 2019 29th International Symposium on Power and Timing Modeling, Optimization and Simulation (PATMOS) | 2019 | IEEE Conferences
R. K. Kodali; A. Valdas | MQTT Based Monitoring System for Urban Farmers Using ESP32 and Raspberry Pi | https://ieeexplore.ieee.org/stamp/stamp.jsp?arnumber=8752995 | ns | ns |  |  | 2018 Second International Conference on Green Computing and Internet of Things (ICGCIoT) | 2018 | IEEE Conferences
G. Suciu; O. Fratu; A. Vulpe; C. Butca; V. Suciu | IoT agro-meteorology for viticulture disease warning | https://ieeexplore.ieee.org/stamp/stamp.jsp?arnumber=7901572 | ns | no |  |  | 2016 IEEE International Black Sea Conference on Communications and Networking (BlackSeaCom) | 2016 | IEEE Conferences
Y. L. K. Macayana; V. A. Coronel; I. C. Fernandez; K. Ung; C. Miras; C. V. Densing; D. Ong; I. Austria; M. Talampas; N. Tiglao; M. T. De Leon; P. Magpantay; M. Rosales | Implementation of 6LoWPAN and Controller Area Network for a Smart Hydroponics System | https://ieeexplore.ieee.org/stamp/stamp.jsp?arnumber=8766373 | no |  |  |  | 2019 Global IoT Summit (GIoTS) | 2019 | IEEE Conferences
I. Zyrianoff; A. Heideker; D. Silva; C. Kamienski | Scalability of an Internet of Things Platform for Smart Water Management for Agriculture | https://ieeexplore.ieee.org/stamp/stamp.jsp?arnumber=8588086 | ns | ns |  |  | 2018 23rd Conference of Open Innovations Association (FRUCT) | 2018 | IEEE Conferences
S. Giordano; I. Seitanidis; M. Ojo; D. Adami; F. Vignoli | IoT solutions for crop protection against wild animal attacks | https://ieeexplore.ieee.org/stamp/stamp.jsp?arnumber=8385275 | ns | ns | wild animal attack prevention |  | 2018 IEEE International Conference on Environmental Engineering (EE) | 2018 | IEEE Conferences
D. Ferreira; P. Corista; J. Gião; S. Ghimire; J. Sarraipa; R. Jardim-Gonçalves | Towards smart agriculture using FIWARE enablers | https://ieeexplore.ieee.org/stamp/stamp.jsp?arnumber=8280066 | ns | ns |  |  | 2017 International Conference on Engineering, Technology and Innovation (ICE/ITMC) | 2017 | IEEE Conferences
V. D. Bachuwar; U. R. Ghodake; A. Lakhssassi; S. S. Suryavanshi | WSN/Wi-Fi Microchip-Based Agriculture Parameter Monitoring using IoT | https://ieeexplore.ieee.org/stamp/stamp.jsp?arnumber=8748638 | ns | ns | monitoring system |  | 2018 International Conference on Smart Systems and Inventive Technology (ICSSIT) | 2018 | IEEE Conferences
S. Monteleone; E. A. de Moraes; R. F. Maia | Analysis of the variables that affect the intention to adopt Precision Agriculture for smart water management in Agriculture 4.0 context | https://ieeexplore.ieee.org/stamp/stamp.jsp?arnumber=8766384 | ns | no |  |  | 2019 Global IoT Summit (GIoTS) | 2019 | IEEE Conferences
L. Zhao; Y. Zhou; I. Matsuo; S. K. Korkua; W. Lee | The Design of a Holistic IoT-Based Monitoring System for a Wind Turbine | https://ieeexplore.ieee.org/stamp/stamp.jsp?arnumber=8733375 | ns | no |  |  | 2019 IEEE/IAS 55th Industrial and Commercial Power Systems Technical Conference (I&CPS) | 2019 | IEEE Conferences
A. N. Babadi; M. Niyazi; R. A. Coutu | Serviceability Optimization of the Next Generation Wind Turbines Using Internet of Things Platform | https://ieeexplore.ieee.org/stamp/stamp.jsp?arnumber=8777861 | ns | no |  |  | 2018 Smart Grid Conference (SGC) | 2018 | IEEE Conferences
A. N. Prasad; K. A. Mamun; F. R. Islam; H. Haqva | Smart water quality monitoring system | https://ieeexplore.ieee.org/stamp/stamp.jsp?arnumber=7476234 | no | no |  |  | 2015 2nd Asia-Pacific World Congress on Computer Science and Engineering (APWC on CSE) | 2015 | IEEE Conferences
T. Qiu; H. Xiao; P. Zhou | Framework and case studies of intelligence monitoring platform in facility agriculture ecosystem | https://ieeexplore.ieee.org/stamp/stamp.jsp?arnumber=6621976 | ns | ns | no irrigation |  | 2013 Second International Conference on Agro-Geoinformatics (Agro-Geoinformatics) | 2013 | IEEE Conferences
D. C. Tsouros; A. Triantafyllou; S. Bibi; P. G. Sarigannidis | Data Acquisition and Analysis Methods in UAV- based Applications for Precision Agriculture | https://ieeexplore.ieee.org/stamp/stamp.jsp?arnumber=8804807 | ns | no |  |  | 2019 15th International Conference on Distributed Computing in Sensor Systems (DCOSS) | 2019 | IEEE Conferences
A. Carvalho; N. O’Mahony; L. Krpalkova; S. Campbell; J. Walsh; P. Doody | Farming on the edge: Architectural Goals | https://ieeexplore.ieee.org/stamp/stamp.jsp?arnumber=8820424 | ns | no |  |  | 2019 8th International Conference on Agro-Geoinformatics (Agro-Geoinformatics) | 2019 | IEEE Conferences
N. A. M. Leh; M. S. A. M. Kamaldin; Z. Muhammad; N. A. Kamarzaman | Smart Irrigation System Using Internet of Things | https://ieeexplore.ieee.org/stamp/stamp.jsp?arnumber=8906497 | ns | ns |  |  | 2019 IEEE 9th International Conference on System Engineering and Technology (ICSET) | 2019 | IEEE Conferences
R. Mulenga; J. Kalezhi; S. K. Musonda; S. Silavwe | Applying Internet of Things in Monitoring and Control of an Irrigation System for Sustainable Agriculture for Small-Scale Farmers in Rural Communities | https://ieeexplore.ieee.org/stamp/stamp.jsp?arnumber=8521025 | ns | ns |  |  | 2018 IEEE PES/IAS PowerAfrica | 2018 | IEEE Conferences
M. Moness; A. M. Moustafa | A Survey of Cyber-Physical Advances and Challenges of Wind Energy Conversion Systems: Prospects for Internet of Energy | https://ieeexplore.ieee.org/stamp/stamp.jsp?arnumber=7264965 | ns | no |  |  | IEEE Internet of Things Journal | 2016 | IEEE Journals
A. N. Harun; R. Ahmad; N. Mohamed; A. R. Abdul Rahim; S. Khan | The effect of different light treatments on nutrient concentration and leaf exchange in Brassica Chinensis | https://ieeexplore.ieee.org/stamp/stamp.jsp?arnumber=8688795 | ns | no |  |  | 2018 IEEE 5th International Conference on Smart Instrumentation, Measurement and Application (ICSIMA) | 2018 | IEEE Conferences
K. Nalinaksh; V. Rishiwal; M. Ganzha; M. Paprzycki | An Internet of Things (IoT) solution framework for agriculture in India and other Third World countries | https://ieeexplore.ieee.org/stamp/stamp.jsp?arnumber=8776792 | ns | no |  |  | 2018 Fourth International Conference on Advances in Computing, Communication & Automation (ICACCA) | 2018 | IEEE Conferences
M. Manju; V. Karthik; S. Hariharan; B. Sreekar | Real time monitoring of the environmental parameters of an aquaponic system based on Internet of Things | https://ieeexplore.ieee.org/stamp/stamp.jsp?arnumber=8261342 | no |  |  |  | 2017 Third International Conference on Science Technology Engineering & Management (ICONSTEM) | 2017 | IEEE Conferences
S. Abraham; A. Shahbazian; K. Dao; H. Tran; P. Thompson | An Internet of Things (IoT)-based aquaponics facility | https://ieeexplore.ieee.org/stamp/stamp.jsp?arnumber=8239339 | no |  |  |  | 2017 IEEE Global Humanitarian Technology Conference (GHTC) | 2017 | IEEE Conferences
H. Durmuş; E. O. Güneş | Integration of the Mobile Robot and Internet of Things to Collect Data from the Agricultural Fields | https://ieeexplore.ieee.org/stamp/stamp.jsp?arnumber=8820578 | ns | no |  |  | 2019 8th International Conference on Agro-Geoinformatics (Agro-Geoinformatics) | 2019 | IEEE Conferences
G. Gagliarde; M. Iadaresta; A. Mennella; G. Bonanomi; M. Idbella | A new system for agrometereological data collection in areas lacking communication networks | https://ieeexplore.ieee.org/stamp/stamp.jsp?arnumber=8909227 | ns | ns | ?? |  | 2019 IEEE International Workshop on Metrology for Agriculture and Forestry (MetroAgriFor) | 2019 | IEEE Conferences
T. A. A. Ali; V. Choksi; M. B. Potdar | Precision Agriculture Monitoring System Using Green Internet of Things (G-IoT) | https://ieeexplore.ieee.org/stamp/stamp.jsp?arnumber=8553866 | ns | ns |  |  | 2018 2nd International Conference on Trends in Electronics and Informatics (ICOEI) | 2018 | IEEE Conferences
T. C. J. Jeaunita; V. Sarasvathi; M. S. Harsha; B. M. Bhavani; T. Kavyashree | An automated greenhouse system using agricultural Internet of Things for better crop yield | https://ieeexplore.ieee.org/stamp/stamp.jsp?arnumber=8643194 | ns | ns |  |  | Smart Cities Symposium 2018 | 2018 | IET Conferences
D. Gupta; M. Belwal | Pest Identification and Control of Diseases in Crop Fields through Image Processing and Tracking of Atmospheric Parameters | https://ieeexplore.ieee.org/stamp/stamp.jsp?arnumber=8653695 | ns | no |  |  | 2018 2nd International Conference on I-SMAC (IoT in Social, Mobile, Analytics and Cloud) (I-SMAC)I-SMAC (IoT in Social, Mobile, Analytics and Cloud) (I-SMAC), 2018 2nd International Conference on | 2018 | IEEE Conferences
N. Kitpo; Y. Kugai; M. Inoue; T. Yokemura; S. Satomura | Internet of Things for Greenhouse Monitoring System Using Deep Learning and Bot Notification Services | https://ieeexplore.ieee.org/stamp/stamp.jsp?arnumber=8661999 | ns | no |  |  | 2019 IEEE International Conference on Consumer Electronics (ICCE) | 2019 | IEEE Conferences
Ho Jung Chang; Byung Min Park; Sang Hee Lee; Yang Geun Jo; Ji Mook Kim; Jae Jin Jung; Jaeho Pyee | Preparation and characterization of organic light emitting devices using hybrid encapsulation materials properties of OLED using hybrid encapuslaton materials | https://ieeexplore.ieee.org/stamp/stamp.jsp?arnumber=7111036 | ns | no |  |  | 2015 International Conference on Electronics Packaging and iMAPS All Asia Conference (ICEP-IAAC) | 2015 | IEEE Conferences
A. Maiti; T. Byrne; A. A. Kist | Teaching Internet of Things in a Collaborative Laboratory Environment | https://ieeexplore.ieee.org/stamp/stamp.jsp?arnumber=8876480 | ns | no |  |  | 2019 5th Experiment International Conference (exp.at'19) | 2019 | IEEE Conferences
R. Arjona; A. Fumagalli; C. Lee; K. Vijayasankar | An Experimental End-to-End Delay Study of a Sub-1GHz Wireless Sensor Network with LTE Backhaul | https://ieeexplore.ieee.org/stamp/stamp.jsp?arnumber=8647618 | ns | no |  |  | 2018 IEEE Global Communications Conference (GLOBECOM) | 2018 | IEEE Conferences
V. Maraš; T. Popović; S. Gajinov; M. Mugoša; V. Popović; A. Savović; K. Pavićević; V. Mirović | Optimal Irrigation as a tool of Precision Agriculture | https://ieeexplore.ieee.org/stamp/stamp.jsp?arnumber=8760145 | ns | ns |  |  | 2019 8th Mediterranean Conference on Embedded Computing (MECO) | 2019 | IEEE Conferences
G. Villani; P. Castaldi; A. Toscano; C. Stanghellini; T. S. Cinotti; R. F. Maia; F. Tomei; M. Taumberger; P. Zanetti; S. Panizzi | Soil Water Balance Model CRITERIA-ID in SWAMP Project: Proof of Concept | https://ieeexplore.ieee.org/stamp/stamp.jsp?arnumber=8588079 | ns | no |  |  | 2018 23rd Conference of Open Innovations Association (FRUCT) | 2018 | IEEE Conferences
J. Byabazaire; C. Olariu; M. Taneja; A. Davy | Lameness Detection as a Service: Application of Machine Learning to an Internet of Cattle | https://ieeexplore.ieee.org/stamp/stamp.jsp?arnumber=8651681 | no |  |  |  | 2019 16th IEEE Annual Consumer Communications & Networking Conference (CCNC) | 2019 | IEEE Conferences
G. Horng; M. Liu; C. Chen | The Smart Image Recognition Mechanism for Crop Harvesting System in Intelligent Agriculture | https://ieeexplore.ieee.org/stamp/stamp.jsp?arnumber=8906085 | ns | no |  |  | IEEE Sensors Journal | 2019 | IEEE Early Access Articles
M. Ji; J. Yoon; J. Choo; M. Jang; A. Smith | LoRa-based Visual Monitoring Scheme for Agriculture IoT | https://ieeexplore.ieee.org/stamp/stamp.jsp?arnumber=8706100 | ns | ns |  |  | 2019 IEEE Sensors Applications Symposium (SAS) | 2019 | IEEE Conferences
A. N. Harun; M. R. M. Kassim; I. Mat; S. S. Ramli | Precision irrigation using Wireless Sensor Network | https://ieeexplore.ieee.org/stamp/stamp.jsp?arnumber=7322513 | ns | ns |  |  | 2015 International Conference on Smart Sensors and Application (ICSSA) | 2015 | IEEE Conferences
C. Razafimandimby; V. Loscri; A. M. Vegni; A. Neri | Efficient Bayesian Communication Approach for Smart Agriculture Applications | https://ieeexplore.ieee.org/stamp/stamp.jsp?arnumber=8288147 | ns | no |  |  | 2017 IEEE 86th Vehicular Technology Conference (VTC-Fall) | 2017 | IEEE Conferences
G. Marques; R. Pitarma | Agricultural environment monitoring system using wireless sensor networks and IoT | https://ieeexplore.ieee.org/stamp/stamp.jsp?arnumber=8399320 | ns | ns |  |  | 2018 13th Iberian Conference on Information Systems and Technologies (CISTI) | 2018 | IEEE Conferences
K. Tsai; Y. Huang; F. Leu; I. You; Y. Huang; C. Tsai | AES-128 Based Secure Low Power Communication for LoRaWAN IoT Environments | https://ieeexplore.ieee.org/stamp/stamp.jsp?arnumber=8404071 | ns | ns |  |  | IEEE Access | 2018 | IEEE Journals
L. Zhu; P. Chen | A Compact, Zero-Power and Low-Noise Harmonic-Transponder for Liquid and Moisture Sensing | https://ieeexplore.ieee.org/stamp/stamp.jsp?arnumber=8888609 | ns | ns |  |  | 2019 IEEE International Symposium on Antennas and Propagation and USNC-URSI Radio Science Meeting | 2019 | IEEE Conferences
Q. Li; Z. Liu; J. Xiao | A Data Collection Collar for Vital Signs of Cows on the Grassland Based on LoRa | https://ieeexplore.ieee.org/stamp/stamp.jsp?arnumber=8592652 | no |  |  |  | 2018 IEEE 15th International Conference on e-Business Engineering (ICEBE) | 2018 | IEEE Conferences
A. A. ElSabaa; M. Ward; W. Wu | Hybrid Localization techniques in LoRa-based WSN | https://ieeexplore.ieee.org/stamp/stamp.jsp?arnumber=8895196 | ns | ns |  |  | 2019 25th International Conference on Automation and Computing (ICAC) | 2019 | IEEE Conferences
O. Debauche; M. El Moulat; S. Mahmoudi; P. Manneback; F. Lebeau | Irrigation pivot-center connected at low cost for the reduction of crop water requirements | https://ieeexplore.ieee.org/stamp/stamp.jsp?arnumber=8360259 | ns | ns |  |  | 2018 International Conference on Advanced Communication Technologies and Networking (CommNet) | 2018 | IEEE Conferences
K. Sangsanit; C. Techapanupreeda | NodeMCU Choreography Automation by CoAP | https://ieeexplore.ieee.org/stamp/stamp.jsp?arnumber=8718123 | ns | no | composition model-driven automation |  | 2019 International Conference on Information Networking (ICOIN) | 2019 | IEEE Conferences
Z. Li; J. Wang; R. Higgs; L. Zhou; W. Yuan | Design of an Intelligent Management System for Agricultural Greenhouses Based on the Internet of Things | https://ieeexplore.ieee.org/stamp/stamp.jsp?arnumber=8005989 | ns | ns |  |  | 2017 IEEE International Conference on Computational Science and Engineering (CSE) and IEEE International Conference on Embedded and Ubiquitous Computing (EUC) | 2017 | IEEE Conferences
N. Shaghaghi; P. Ferguson; J. Mayer; Z. Cameron; B. Dezfouli | A Low-power Wireless Sensing Unit for Hydro-System Automation | https://ieeexplore.ieee.org/stamp/stamp.jsp?arnumber=8666457 | no |  |  |  | 2019 IEEE 9th Annual Computing and Communication Workshop and Conference (CCWC) | 2019 | IEEE Conferences
N. H. Mahmood; N. Pratas; T. Jacobsen; P. Mogensen | On the performance of one stage massive random access protocols in 5G systems | https://ieeexplore.ieee.org/stamp/stamp.jsp?arnumber=7593133 | ns | no |  |  | 2016 9th International Symposium on Turbo Codes and Iterative Information Processing (ISTC) | 2016 | IEEE Conferences
D. Hanyurwimfura; E. Nizeyimana; F. Ndikumana; D. Mukanyiligira; A. Bakar Diwani; F. Mukamanzi | Monitoring System to Strive against Fall Armyworm in Crops Case Study: Maize in Rwanda | https://ieeexplore.ieee.org/stamp/stamp.jsp?arnumber=8560024 | ns | no |  |  | 2018 IEEE SmartWorld, Ubiquitous Intelligence & Computing, Advanced & Trusted Computing, Scalable Computing & Communications, Cloud & Big Data Computing, Internet of People and Smart City Innovation (SmartWorld/SCALCOM/UIC/ATC/CBDCom/IOP/SCI) | 2018 | IEEE Conferences
A. Zakeri; M. Saberi; O. K. Hussain; E. Chang | Early Detection of Events as a Decision Support in the Milk Collection Planning | https://ieeexplore.ieee.org/stamp/stamp.jsp?arnumber=8607443 | no |  |  |  | 2018 IEEE International Conference on Industrial Engineering and Engineering Management (IEEM) | 2018 | IEEE Conferences
M. Mancini; P. Nassisi; A. Trabucco; A. Meloni; K. Toli; V. Bacciu; G. Aloisio; D. Spano; S. Mereu | An Open Source and Low-Cost Internet of Things-enabled Service for Irrigation Management | https://ieeexplore.ieee.org/stamp/stamp.jsp?arnumber=8914230 | ns | yes | irrigation management | ns | 2019 IEEE International Conference on Systems, Man and Cybernetics (SMC) | 2019 | IEEE Conferences
S. Andreev; C. Dobre | The Internet of Things and Sensor Networks | https://ieeexplore.ieee.org/stamp/stamp.jsp?arnumber=8847229 | ns | no | unrelated |  | IEEE Communications Magazine | 2019 | IEEE Magazines
 | Table of contents | https://ieeexplore.ieee.org/stamp/stamp.jsp?arnumber=6913248 | ns | no | unrelated |  | 2014 IIAI 3rd International Conference on Advanced Applied Informatics | 2014 | IEEE Conferences

Sheet: 시트2
Authors | Title | PDF Link | LORA? | Publication Title | Publication Year | Document Identifier
P. Serikul; N. Nakpong; N. Nakjuatong | Smart Farm Monitoring via the Blynk IoT Platform : Case Study: Humidity Monitoring and Data Recording | https://ieeexplore.ieee.org/stamp/stamp.jsp?arnumber=8612441 |  | 2018 16th International Conference on ICT and Knowledge Engineering (ICT&KE) | 2018 | IEEE Conferences
Y. Mekonnen; L. Burton; A. Sarwat; S. Bhansali | IoT Sensor Network Approach for Smart Farming: An Application in Food, Energy and Water System | https://ieeexplore.ieee.org/stamp/stamp.jsp?arnumber=8601701 |  | 2018 IEEE Global Humanitarian Technology Conference (GHTC) | 2018 | IEEE Conferences
R. Dagar; S. Som; S. K. Khatri | Smart Farming – IoT in Agriculture | https://ieeexplore.ieee.org/stamp/stamp.jsp?arnumber=8597264 |  | 2018 International Conference on Inventive Research in Computing Applications (ICIRCA) | 2018 | IEEE Conferences
C. Yoon; M. Huh; S. Kang; J. Park; C. Lee | Implement smart farm with IoT technology | https://ieeexplore.ieee.org/stamp/stamp.jsp?arnumber=8323908 |  | 2018 20th International Conference on Advanced Communication Technology (ICACT) | 2018 | IEEE Conferences
M. S. Farooq; S. Riaz; A. Abid; K. Abid; M. A. Naeem | A Survey on the Role of IoT in Agriculture for the Implementation of Smart Farming | https://ieeexplore.ieee.org/stamp/stamp.jsp?arnumber=8883163 |  | IEEE Access | 2019 | IEEE Journals
Amandeep; A. Bhattacharjee; P. Das; D. Basu; S. Roy; S. Ghosh; S. Saha; S. Pain; S. Dey; T. K. Rana | Smart farming using IOT | https://ieeexplore.ieee.org/stamp/stamp.jsp?arnumber=8117219 |  | 2017 8th IEEE Annual Information Technology, Electronics and Mobile Communication Conference (IEMCON) | 2017 | IEEE Conferences
R. K. Kodali; S. Yerroju; S. Sahu | Smart Farm Monitoring Using LoRa Enabled IoT | https://ieeexplore.ieee.org/stamp/stamp.jsp?arnumber=8753086 | yes | 2018 Second International Conference on Green Computing and Internet of Things (ICGCIoT) | 2018 | IEEE Conferences
A. Kamilaris; F. Gao; F. X. Prenafeta-Boldu; M. I. Ali | Agri-IoT: A semantic framework for Internet of Things-enabled smart farming applications | https://ieeexplore.ieee.org/stamp/stamp.jsp?arnumber=7845467 |  | 2016 IEEE 3rd World Forum on Internet of Things (WF-IoT) | 2016 | IEEE Conferences
J. D. Stevens; T. Shaikh | MicroCEA: Developing a Personal Urban Smart Farming Device | https://ieeexplore.ieee.org/stamp/stamp.jsp?arnumber=8541311 |  | 2018 2nd International Conference on Smart Grid and Smart Cities (ICSGSC) | 2018 | IEEE Conferences
S. Suakanto; V. J. L. Engel; M. Hutagalung; D. Angela | Sensor networks data acquisition and task management for decision support of smart farming | https://ieeexplore.ieee.org/stamp/stamp.jsp?arnumber=7858233 |  | 2016 International Conference on Information Technology Systems and Innovation (ICITSI) | 2016 | IEEE Conferences
I. Mat; M. R. Mohd Kassim; A. N. Harun; I. M. Yusoff | Smart Agriculture Using Internet of Things | https://ieeexplore.ieee.org/stamp/stamp.jsp?arnumber=8632817 |  | 2018 IEEE Conference on Open Systems (ICOS) | 2018 | IEEE Conferences
A. A. Shakir; F. Hakim; M. Rasheduzzaman; S. Chakraborty; T. U. Ahmed; S. Hossain | Design and Implementation of SENSEP ACK: An IoT Based Mushroom Cultivation Monitoring System | https://ieeexplore.ieee.org/stamp/stamp.jsp?arnumber=8679183 |  | 2019 International Conference on Electrical, Computer and Communication Engineering (ECCE) | 2019 | IEEE Conferences
S. Verma; R. Gala; S. Madhavan; S. Burkule; S. Chauhan; C. Prakash | An Internet of Things (IoT) Architecture for Smart Agriculture | https://ieeexplore.ieee.org/stamp/stamp.jsp?arnumber=8697707 |  | 2018 Fourth International Conference on Computing Communication Control and Automation (ICCUBEA) | 2018 | IEEE Conferences
T. Wiangtong; P. Sirisuk | IoT-based Versatile Platform for Precision Farming | https://ieeexplore.ieee.org/stamp/stamp.jsp?arnumber=8587989 |  | 2018 18th International Symposium on Communications and Information Technologies (ISCIT) | 2018 | IEEE Conferences
M. M. Maha; S. Bhuiyan; M. Masuduzzaman | Smart Board for Precision Farming Using Wireless Sensor Network | https://ieeexplore.ieee.org/stamp/stamp.jsp?arnumber=8644215 |  | 2019 International Conference on Robotics,Electrical and Signal Processing Techniques (ICREST) | 2019 | IEEE Conferences
R. G. Baldovino; I. C. Valenzuela; E. P. Dadios | Implementation of a Low-power Wireless Sensor Network for Smart Farm Applications | https://ieeexplore.ieee.org/stamp/stamp.jsp?arnumber=8666262 |  | 2018 IEEE 10th International Conference on Humanoid, Nanotechnology, Information Technology,Communication and Control, Environment and Management (HNICEM) | 2018 | IEEE Conferences
P. Sureephong; P. Wiangnak; S. Wicha | The comparison of soil sensors for integrated creation of IOT-based Wetting front detector (WFD) with an efficient irrigation system to support precision farming | https://ieeexplore.ieee.org/stamp/stamp.jsp?arnumber=7904949 |  | 2017 International Conference on Digital Arts, Media and Technology (ICDAMT) | 2017 | IEEE Conferences
S. R. Prathibha; A. Hongal; M. P. Jyothi | IOT Based Monitoring System in Smart Agriculture | https://ieeexplore.ieee.org/stamp/stamp.jsp?arnumber=8081906 |  | 2017 International Conference on Recent Advances in Electronics and Communication Technology (ICRAECT) | 2017 | IEEE Conferences
C. Yoon; M. Huh; S. Kang; J. Park; C. Lee | Implement smart farm with IoT technology | https://ieeexplore.ieee.org/stamp/stamp.jsp?arnumber=8323907 |  | 2018 20th International Conference on Advanced Communication Technology (ICACT) | 2018 | IEEE Conferences
P. Dedeepya; U. S. A. Srinija; M. Gowtham Krishna; G. Sindhusha; T. Gnanesh | Smart Greenhouse Farming based on IOT | https://ieeexplore.ieee.org/stamp/stamp.jsp?arnumber=8474713 |  | 2018 Second International Conference on Electronics, Communication and Aerospace Technology (ICECA) | 2018 | IEEE Conferences
E. M. E. Ahmed; K. H. B. Abdalla; I. k. Eltahir | Farm Automation based on IoT | https://ieeexplore.ieee.org/stamp/stamp.jsp?arnumber=8515853 |  | 2018 International Conference on Computer, Control, Electrical, and Electronics Engineering (ICCCEEE) | 2018 | IEEE Conferences
J. Bauer; N. Aschenbruck | Design and implementation of an agricultural monitoring system for smart farming | https://ieeexplore.ieee.org/stamp/stamp.jsp?arnumber=8373022 |  | 2018 IoT Vertical and Topical Summit on Agriculture - Tuscany (IOT Tuscany) | 2018 | IEEE Conferences
K. Bounnady; P. Sibounnavong; K. Chanthavong; S. Saypadith | Smart Crop Cultivation Monitoring System by Using IoT | https://ieeexplore.ieee.org/stamp/stamp.jsp?arnumber=8802584 |  | 2019 5th International Conference on Engineering, Applied Sciences and Technology (ICEAST) | 2019 | IEEE Conferences
S. B. Saraf; D. H. Gawali | IoT based smart irrigation monitoring and controlling system | https://ieeexplore.ieee.org/stamp/stamp.jsp?arnumber=8256711 |  | 2017 2nd IEEE International Conference on Recent Trends in Electronics, Information & Communication Technology (RTEICT) | 2017 | IEEE Conferences
H. Shahinzadeh; J. Moradi; G. B. Gharehpetian; H. Nafisi; M. Abedi | IoT Architecture for Smart Grids | https://ieeexplore.ieee.org/stamp/stamp.jsp?arnumber=8641944 |  | 2019 International Conference on Protection and Automation of Power System (IPAPS) | 2019 | IEEE Conferences
N. Putjaika; S. Phusae; A. Chen-Im; P. Phunchongharn; K. Akkarajitsakul | A control system in an intelligent farming by using arduino technology | https://ieeexplore.ieee.org/stamp/stamp.jsp?arnumber=7519234 |  | 2016 Fifth ICT International Student Project Conference (ICT-ISPC) | 2016 | IEEE Conferences
S. J. Balakrishna; H. Marellapudi; N. Alivelu Manga | Iot Based Status Tracking and Controlling of Motor in Agricultural Farms | https://ieeexplore.ieee.org/stamp/stamp.jsp?arnumber=8596944 |  | 2018 5th IEEE Uttar Pradesh Section International Conference on Electrical, Electronics and Computer Engineering (UPCON) | 2018 | IEEE Conferences
M. Ryu; J. Yun; T. Miao; I. Ahn; S. Choi; J. Kim | Design and implementation of a connected farm for smart farming system | https://ieeexplore.ieee.org/stamp/stamp.jsp?arnumber=7370624 |  | 2015 IEEE SENSORS | 2015 | IEEE Conferences
S. Vaishali; S. Suraj; G. Vignesh; S. Dhivya; S. Udhayakumar | Mobile integrated smart irrigation management and monitoring system using IOT | https://ieeexplore.ieee.org/stamp/stamp.jsp?arnumber=8286792 |  | 2017 International Conference on Communication and Signal Processing (ICCSP) | 2017 | IEEE Conferences
M. Bhagat; D. Kumar; D. Kumar | Role of Internet of Things (IoT) in Smart Farming: A Brief Survey | https://ieeexplore.ieee.org/stamp/stamp.jsp?arnumber=8783800 |  | 2019 Devices for Integrated Circuit (DevIC) | 2019 | IEEE Conferences
I. Haris; A. Fasching; L. Punzenberger; R. Grosu | CPS/IoT Ecosystem: Indoor Vertical Farming System | https://ieeexplore.ieee.org/stamp/stamp.jsp?arnumber=8900974 |  | 2019 IEEE 23rd International Symposium on Consumer Technologies (ISCT) | 2019 | IEEE Conferences
M. Hate; S. Jadhav; H. Patil | Vegetable Traceability with Smart Irrigation | https://ieeexplore.ieee.org/stamp/stamp.jsp?arnumber=8537253 |  | 2018 International Conference on Smart City and Emerging Technology (ICSCET) | 2018 | IEEE Conferences
V. Bojan; I. Raducu; F. Pop; M. Mocanu; V. Cristea | Cloud-based service for time series analysis and visualisation in Farm Management System | https://ieeexplore.ieee.org/stamp/stamp.jsp?arnumber=7312697 |  | 2015 IEEE International Conference on Intelligent Computer Communication and Processing (ICCP) | 2015 | IEEE Conferences
K. P. Satamraju; K. Shaik; N. Vellanki | RURAL BRIDGE: A novel system for smart and co-operative farming using IoT architecture | https://ieeexplore.ieee.org/stamp/stamp.jsp?arnumber=8363966 |  | 2017 International Conference on Multimedia, Signal Processing and Communication Technologies (IMPACT) | 2017 | IEEE Conferences
P. Padalalu; S. Mahajan; K. Dabir; S. Mitkar; D. Javale | Smart water dripping system for agriculture/farming | https://ieeexplore.ieee.org/stamp/stamp.jsp?arnumber=8226212 |  | 2017 2nd International Conference for Convergence in Technology (I2CT) | 2017 | IEEE Conferences
R. Prabha; E. Sinitambirivoutin; F. Passelaigue; M. V. Ramesh | Design and Development of an IoT Based Smart Irrigation and Fertilization System for Chilli Farming | https://ieeexplore.ieee.org/stamp/stamp.jsp?arnumber=8538568 |  | 2018 International Conference on Wireless Communications, Signal Processing and Networking (WiSPNET) | 2018 | IEEE Conferences
M. Bacco; A. Berton; E. Ferro; C. Gennaro; A. Gotta; S. Matteoli; F. Paonessa; M. Ruggeri; G. Virone; A. Zanella | Smart farming: Opportunities, challenges and technology enablers | https://ieeexplore.ieee.org/stamp/stamp.jsp?arnumber=8373043 |  | 2018 IoT Vertical and Topical Summit on Agriculture - Tuscany (IOT Tuscany) | 2018 | IEEE Conferences
V. Lohchab; M. Kumar; G. Suryan; V. Gautam; R. K. Das | A Review of IoT based Smart Farm Monitoring | https://ieeexplore.ieee.org/stamp/stamp.jsp?arnumber=8473337 |  | 2018 Second International Conference on Inventive Communication and Computational Technologies (ICICCT) | 2018 | IEEE Conferences
S. N. Nnadi; F. E. Idachaba | Design and Implementation of a Sustainable IOT Enabled Greenhouse Prototype | https://ieeexplore.ieee.org/stamp/stamp.jsp?arnumber=8517006 |  | 2018 IEEE 5G World Forum (5GWF) | 2018 | IEEE Conferences
M. Dholu; K. A. Ghodinde | Internet of Things (IoT) for Precision Agriculture Application | https://ieeexplore.ieee.org/stamp/stamp.jsp?arnumber=8553720 |  | 2018 2nd International Conference on Trends in Electronics and Informatics (ICOEI) | 2018 | IEEE Conferences
S. Pallavi; J. D. Mallapur; K. Y. Bendigeri | Remote sensing and controlling of greenhouse agriculture parameters based on IoT | https://ieeexplore.ieee.org/stamp/stamp.jsp?arnumber=8336571 |  | 2017 International Conference on Big Data, IoT and Data Science (BID) | 2017 | IEEE Conferences
S. Roy; R. Ray; A. Roy; S. Sinha; G. Mukherjee; S. Pyne; S. Mitra; S. Basu; S. Hazra | IoT, big data science & analytics, cloud computing and mobile app based hybrid system for smart agriculture | https://ieeexplore.ieee.org/stamp/stamp.jsp?arnumber=8079610 |  | 2017 8th Annual Industrial Automation and Electromechanical Engineering Conference (IEMECON) | 2017 | IEEE Conferences
N. Ahmed; D. De; I. Hussain | Internet of Things (IoT) for Smart Precision Agriculture and Farming in Rural Areas | https://ieeexplore.ieee.org/stamp/stamp.jsp?arnumber=8521668 |  | IEEE Internet of Things Journal | 2018 | IEEE Journals
A. Khandelwal; A. V. Singh; S. K. Khatri | Diverse IoT Based Gadgets to Update a Moderate Condition of Farmers in India | https://ieeexplore.ieee.org/stamp/stamp.jsp?arnumber=8701272 |  | 2019 Amity International Conference on Artificial Intelligence (AICAI) | 2019 | IEEE Conferences
P. M. Gupta; M. Salpekar; P. K. Tejan | Agricultural practices Improvement Using IoT Enabled SMART Sensors | https://ieeexplore.ieee.org/stamp/stamp.jsp?arnumber=8537291 |  | 2018 International Conference on Smart City and Emerging Technology (ICSCET) | 2018 | IEEE Conferences
A. Ordoñez-García; M. Siller; O. Begovich | IoT architecture for urban agronomy and precision applications | https://ieeexplore.ieee.org/stamp/stamp.jsp?arnumber=8261582 |  | 2017 IEEE International Autumn Meeting on Power, Electronics and Computing (ROPEC) | 2017 | IEEE Conferences
P. Rekha; V. P. Rangan; M. V. Ramesh; K. V. Nibi | High yield groundnut agronomy: An IoT based precision farming framework | https://ieeexplore.ieee.org/stamp/stamp.jsp?arnumber=8239287 |  | 2017 IEEE Global Humanitarian Technology Conference (GHTC) | 2017 | IEEE Conferences
I. Roussaki; P. Kosmides; G. Routis; K. Doolin; V. Pevtschin; A. Marguglio | A Multi-Actor Approach to promote the employment of IoT in Agriculture | https://ieeexplore.ieee.org/stamp/stamp.jsp?arnumber=8766416 |  | 2019 Global IoT Summit (GIoTS) | 2019 | IEEE Conferences
P. B. Sowmiya; B. K. Nagaswetha; D. Priyadharshini | Design of Automatic Nutrition Supply System Using IoT Technique in Modern Cities | https://ieeexplore.ieee.org/stamp/stamp.jsp?arnumber=8067587 |  | 2017 International Conference on Technical Advancements in Computers and Communications (ICTACC) | 2017 | IEEE Conferences
S. Sadowski; P. Spachos | Solar-Powered Smart Agricultural Monitoring System Using Internet of Things Devices | https://ieeexplore.ieee.org/stamp/stamp.jsp?arnumber=8614981 |  | 2018 IEEE 9th Annual Information Technology, Electronics and Mobile Communication Conference (IEMCON) | 2018 | IEEE Conferences
L. Lambrinos | Internet of Things in Agriculture: A Decision Support System for Precision Farming | https://ieeexplore.ieee.org/stamp/stamp.jsp?arnumber=8890447 |  | 2019 IEEE Intl Conf on Dependable, Autonomic and Secure Computing, Intl Conf on Pervasive Intelligence and Computing, Intl Conf on Cloud and Big Data Computing, Intl Conf on Cyber Science and Technology Congress (DASC/PiCom/CBDCom/CyberSciTech) | 2019 | IEEE Conferences
F. Balducci; D. Fomarelli; D. Impedovo; A. Longo; G. Pirlo | Smart Farms for a Sustainable and Optimized Model of Agriculture | https://ieeexplore.ieee.org/stamp/stamp.jsp?arnumber=8577226 |  | 2018 AEIT International Annual Conference | 2018 | IEEE Conferences
P. Srinivasulu; M. S. Babu; R. Venkat; K. Rajesh | Cloud service oriented architecture (CSoA) for agriculture through internet of things (IoT) and big data | https://ieeexplore.ieee.org/stamp/stamp.jsp?arnumber=8191906 |  | 2017 IEEE International Conference on Electrical, Instrumentation and Communication Engineering (ICEICE) | 2017 | IEEE Conferences
K. L. Krishna; O. Silver; W. F. Malende; K. Anuradha | Internet of Things application for implementation of smart agriculture system | https://ieeexplore.ieee.org/stamp/stamp.jsp?arnumber=8058236 |  | 2017 International Conference on I-SMAC (IoT in Social, Mobile, Analytics and Cloud) (I-SMAC) | 2017 | IEEE Conferences
S. B. M. S. S. Gunarathne; S. R. D. Kalingamudali | Smart Automation System for Controlling Various Appliances using a Mobile Device | https://ieeexplore.ieee.org/stamp/stamp.jsp?arnumber=8755104 |  | 2019 IEEE International Conference on Industrial Technology (ICIT) | 2019 | IEEE Conferences
M. Ayaz; M. Ammad-Uddin; Z. Sharif; A. Mansour; E. M. Aggoune | Internet-of-Things (IoT)-Based Smart Agriculture: Toward Making the Fields Talk | https://ieeexplore.ieee.org/stamp/stamp.jsp?arnumber=8784034 |  | IEEE Access | 2019 | IEEE Journals
M. Sheth; P. Rupani | Smart Gardening Automation using IoT With BLYNK App | https://ieeexplore.ieee.org/stamp/stamp.jsp?arnumber=8862591 |  | 2019 3rd International Conference on Trends in Electronics and Informatics (ICOEI) | 2019 | IEEE Conferences
G. Suciu; T. Uşurelu; C. Beceanu; M. A. Dobrea | IoT and Energy Efficiency for Smart Agriculture using Adcon Telemetry Devices | https://ieeexplore.ieee.org/stamp/stamp.jsp?arnumber=8742433 |  | 2018 International Symposium on Fundamentals of Electrical Engineering (ISFEE) | 2018 | IEEE Conferences
A. Roy; A. Datta; J. Siddiquee; B. Poddar; B. Biswas; S. Saha; P. Sarkar | Energy-efficient Data Centers and smart temperature control system with IoT sensing | https://ieeexplore.ieee.org/stamp/stamp.jsp?arnumber=7746251 |  | 2016 IEEE 7th Annual Information Technology, Electronics and Mobile Communication Conference (IEMCON) | 2016 | IEEE Conferences
S. Salvi; S. A. Framed Jain; H. A. Sanjay; T. K. Harshita; M. Farhana; N. Jain; M. V. Suhas | Cloud based data analysis and monitoring of smart multi-level irrigation system using IoT | https://ieeexplore.ieee.org/stamp/stamp.jsp?arnumber=8058279 |  | 2017 International Conference on I-SMAC (IoT in Social, Mobile, Analytics and Cloud) (I-SMAC) | 2017 | IEEE Conferences
B. Yimwadsana; P. Chanthapeth; C. Lertthanyaphan; A. Pornvechamnuay | An IoT Controlled System for Plant Growth | https://ieeexplore.ieee.org/stamp/stamp.jsp?arnumber=8523886 |  | 2018 Seventh ICT International Student Project Conference (ICT-ISPC) | 2018 | IEEE Conferences
P. Suriyachai; J. Pansit | Effective Utilization of IoT for Low-cost Crop Monitoring and Automation | https://ieeexplore.ieee.org/stamp/stamp.jsp?arnumber=8713163 |  | 2018 21st International Symposium on Wireless Personal Multimedia Communications (WPMC) | 2018 | IEEE Conferences
T. M. C. Nguyen; D. B. Hoang | S-MANAGE Protocol For Software-Defined IoT | https://ieeexplore.ieee.org/stamp/stamp.jsp?arnumber=8615336 |  | 2018 28th International Telecommunication Networks and Applications Conference (ITNAC) | 2018 | IEEE Conferences
L. E. Nugroho; A. G. H. Pratama; I. W. Mustika; R. Ferdiana | Development of monitoring system for smart farming using Progressive Web App | https://ieeexplore.ieee.org/stamp/stamp.jsp?arnumber=8250513 |  | 2017 9th International Conference on Information Technology and Electrical Engineering (ICITEE) | 2017 | IEEE Conferences
C. Cambra; S. Sendra; J. Lloret; L. Garcia | An IoT service-oriented system for agriculture monitoring | https://ieeexplore.ieee.org/stamp/stamp.jsp?arnumber=7996640 |  | 2017 IEEE International Conference on Communications (ICC) | 2017 | IEEE Conferences
R. K. Kodali; V. Jain; S. Karagwal | IoT based smart greenhouse | https://ieeexplore.ieee.org/stamp/stamp.jsp?arnumber=7906846 |  | 2016 IEEE Region 10 Humanitarian Technology Conference (R10-HTC) | 2016 | IEEE Conferences
C. Pham; A. Rahim; P. Cousin | Low-cost, Long-range open IoT for smarter rural African villages | https://ieeexplore.ieee.org/stamp/stamp.jsp?arnumber=7580823 |  | 2016 IEEE International Smart Cities Conference (ISC2) | 2016 | IEEE Conferences
V. K. Sarker; J. P. Queralta; T. N. Gia; H. Tenhunen; T. Westerlund | A Survey on LoRa for IoT: Integrating Edge Computing | https://ieeexplore.ieee.org/stamp/stamp.jsp?arnumber=8795313 |  | 2019 Fourth International Conference on Fog and Mobile Edge Computing (FMEC) | 2019 | IEEE Conferences
A. T. Abagissa; A. Behura; S. K. Pani | IoT Based Smart Agricultural Device Controlling System | https://ieeexplore.ieee.org/stamp/stamp.jsp?arnumber=8473126 |  | 2018 Second International Conference on Inventive Communication and Computational Technologies (ICICCT) | 2018 | IEEE Conferences
H. A. M. Tran; H. Q. T. Ngo; T. P. Nguyen; H. Nguyen | Design of Green Agriculture System Using Internet of Things and Image Processing Techniques | https://ieeexplore.ieee.org/stamp/stamp.jsp?arnumber=8595663 |  | 2018 4th International Conference on Green Technology and Sustainable Development (GTSD) | 2018 | IEEE Conferences
S. Pooja; D. V. Uday; U. B. Nagesh; S. G. Talekar | Application of MQTT protocol for real time weather monitoring and precision farming | https://ieeexplore.ieee.org/stamp/stamp.jsp?arnumber=8284616 |  | 2017 International Conference on Electrical, Electronics, Communication, Computer, and Optimization Techniques (ICEECCOT) | 2017 | IEEE Conferences
R. K. Kodali; K. P. Nimmanapalli; S. Jyothirmay | Micro:Bit Based IRRIGATION MONITORING | https://ieeexplore.ieee.org/stamp/stamp.jsp?arnumber=8777721 |  | 2018 4th International Conference on Computing Communication and Automation (ICCCA) | 2018 | IEEE Conferences
S. Jaiganesh; K. Gunaseelan; V. Ellappan | IOT agriculture to improve food and farming technology | https://ieeexplore.ieee.org/stamp/stamp.jsp?arnumber=8073690 |  | 2017 Conference on Emerging Devices and Smart Systems (ICEDSS) | 2017 | IEEE Conferences
M. Ammad Uddin; M. Ayaz; E. M. Aggoune; A. Mansour; D. Le Jeune | Affordable Broad Agile Farming System for Rural and Remote Area | https://ieeexplore.ieee.org/stamp/stamp.jsp?arnumber=8815723 |  | IEEE Access | 2019 | IEEE Journals
M. Lee; H. Kim; H. Yoe | Intelligent environment management system for controlled horticulture | https://ieeexplore.ieee.org/stamp/stamp.jsp?arnumber=8108049 |  | 2017 4th NAFOSTED Conference on Information and Computer Science | 2017 | IEEE Conferences
A. Na; W. Isaac | Developing a human-centric agricultural model in the IoT environment | https://ieeexplore.ieee.org/stamp/stamp.jsp?arnumber=7562740 |  | 2016 International Conference on Internet of Things and Applications (IOTA) | 2016 | IEEE Conferences
A. R. Roselin; A. Jawahar | Smart agro system using wireless sensor networks | https://ieeexplore.ieee.org/stamp/stamp.jsp?arnumber=8250751 |  | 2017 International Conference on Intelligent Computing and Control Systems (ICICCS) | 2017 | IEEE Conferences
P. Corista; D. Ferreira; J. Gião; J. Sarraipa; R. J. Gonçalves | An IoT Agriculture System Using FIWARE | https://ieeexplore.ieee.org/stamp/stamp.jsp?arnumber=8436381 |  | 2018 IEEE International Conference on Engineering, Technology and Innovation (ICE/ITMC) | 2018 | IEEE Conferences
C. Hirsch; E. Bartocci; R. Grosu | Capacitive Soil Moisture Sensor Node for IoT in Agriculture and Home | https://ieeexplore.ieee.org/stamp/stamp.jsp?arnumber=8901012 |  | 2019 IEEE 23rd International Symposium on Consumer Technologies (ISCT) | 2019 | IEEE Conferences
R. K. Kodali; M. S. Kuthada; Y. K. Yogi Borra | LoRa Based Smart Irrigation System | https://ieeexplore.ieee.org/stamp/stamp.jsp?arnumber=8777583 | yes | 2018 4th International Conference on Computing Communication and Automation (ICCCA) | 2018 | IEEE Conferences
D. K. Sreekantha; Kavya A.M. | Agricultural crop monitoring using IOT - a study | https://ieeexplore.ieee.org/stamp/stamp.jsp?arnumber=7855968 |  | 2017 11th International Conference on Intelligent Systems and Control (ISCO) | 2017 | IEEE Conferences
S. Thakare; P. H. Bhagat | Arduino-Based Smart Irrigation Using Sensors and ESP8266 WiFi Module | https://ieeexplore.ieee.org/stamp/stamp.jsp?arnumber=8663041 |  | 2018 Second International Conference on Intelligent Computing and Control Systems (ICICCS) | 2018 | IEEE Conferences
T. Okayasu; A. P. Nugroho; A. Sakai; D. Arita; T. Yoshinaga; R. Taniguchi; M. Horimoto; E. Inoue; Y. Hirai; M. Mitsuoka | Affordable field environmental monitoring and plant growth measurement system for smart agriculture | https://ieeexplore.ieee.org/stamp/stamp.jsp?arnumber=8304486 |  | 2017 Eleventh International Conference on Sensing Technology (ICST) | 2017 | IEEE Conferences
S. Kumar; P. Raja; G. Bhargavi | A Comparative Study on Modern Smart Irrigation System and Monitoring the Field by using IOT | https://ieeexplore.ieee.org/stamp/stamp.jsp?arnumber=8675026 |  | 2018 International Conference on Computing, Power and Communication Technologies (GUCON) | 2018 | IEEE Conferences
K. K. Kumar; S. Rachamalla; S. V. Laxmi; P. Sindhu | Most Economical - IOT based SmartIrrigation Using GSM | https://ieeexplore.ieee.org/stamp/stamp.jsp?arnumber=8724029 |  | 2018 3rd International Conference on Communication and Electronics Systems (ICCES) | 2018 | IEEE Conferences
K. T. E. Keerthana; S. Karpagavalli; A. M. Posonia | Smart System Monitoring Agricultural Land Using Iot | https://ieeexplore.ieee.org/stamp/stamp.jsp?arnumber=8529037 |  | 2018 International Conference on Emerging Trends and Innovations In Engineering And Technological Research (ICETIETR) | 2018 | IEEE Conferences
A. D. Boursianis; M. S. Papadopoulou; P. Damantoulakis; A. Karampatea; P. Doanis; D. Geourgoulas; A. Skoufa; D. Valavanis; C. Apostolidis; D. G. Babas; K. B. Baltzis; T. N. Kaifas; K. Siozios; S. Siskos; T. Samaras; K. Siakavara; S. Nikolaidis; S. K. Goudos; A. Liopa-Tsakalidi; P. Barouchas; I. Kasimis; G. Kalamaras; D. Merkouris; G. Perrakis; C. Tsirogiannis; A. Gotsis; K. Maliatsos | Advancing Rational Exploitation of Water Irrigation Using 5G-IoT Capabilities: The AREThOU5A Project | https://ieeexplore.ieee.org/stamp/stamp.jsp?arnumber=8862146 |  | 2019 29th International Symposium on Power and Timing Modeling, Optimization and Simulation (PATMOS) | 2019 | IEEE Conferences
R. K. Kodali; A. Valdas | MQTT Based Monitoring System for Urban Farmers Using ESP32 and Raspberry Pi | https://ieeexplore.ieee.org/stamp/stamp.jsp?arnumber=8752995 |  | 2018 Second International Conference on Green Computing and Internet of Things (ICGCIoT) | 2018 | IEEE Conferences
I. Zyrianoff; A. Heideker; D. Silva; C. Kamienski | Scalability of an Internet of Things Platform for Smart Water Management for Agriculture | https://ieeexplore.ieee.org/stamp/stamp.jsp?arnumber=8588086 |  | 2018 23rd Conference of Open Innovations Association (FRUCT) | 2018 | IEEE Conferences
S. Giordano; I. Seitanidis; M. Ojo; D. Adami; F. Vignoli | IoT solutions for crop protection against wild animal attacks | https://ieeexplore.ieee.org/stamp/stamp.jsp?arnumber=8385275 |  | 2018 IEEE International Conference on Environmental Engineering (EE) | 2018 | IEEE Conferences
D. Ferreira; P. Corista; J. Gião; S. Ghimire; J. Sarraipa; R. Jardim-Gonçalves | Towards smart agriculture using FIWARE enablers | https://ieeexplore.ieee.org/stamp/stamp.jsp?arnumber=8280066 |  | 2017 International Conference on Engineering, Technology and Innovation (ICE/ITMC) | 2017 | IEEE Conferences
V. D. Bachuwar; U. R. Ghodake; A. Lakhssassi; S. S. Suryavanshi | WSN/Wi-Fi Microchip-Based Agriculture Parameter Monitoring using IoT | https://ieeexplore.ieee.org/stamp/stamp.jsp?arnumber=8748638 |  | 2018 International Conference on Smart Systems and Inventive Technology (ICSSIT) | 2018 | IEEE Conferences
T. Qiu; H. Xiao; P. Zhou | Framework and case studies of intelligence monitoring platform in facility agriculture ecosystem | https://ieeexplore.ieee.org/stamp/stamp.jsp?arnumber=6621976 |  | 2013 Second International Conference on Agro-Geoinformatics (Agro-Geoinformatics) | 2013 | IEEE Conferences
N. A. M. Leh; M. S. A. M. Kamaldin; Z. Muhammad; N. A. Kamarzaman | Smart Irrigation System Using Internet of Things | https://ieeexplore.ieee.org/stamp/stamp.jsp?arnumber=8906497 |  | 2019 IEEE 9th International Conference on System Engineering and Technology (ICSET) | 2019 | IEEE Conferences
R. Mulenga; J. Kalezhi; S. K. Musonda; S. Silavwe | Applying Internet of Things in Monitoring and Control of an Irrigation System for Sustainable Agriculture for Small-Scale Farmers in Rural Communities | https://ieeexplore.ieee.org/stamp/stamp.jsp?arnumber=8521025 |  | 2018 IEEE PES/IAS PowerAfrica | 2018 | IEEE Conferences
G. Gagliarde; M. Iadaresta; A. Mennella; G. Bonanomi; M. Idbella | A new system for agrometereological data collection in areas lacking communication networks | https://ieeexplore.ieee.org/stamp/stamp.jsp?arnumber=8909227 |  | 2019 IEEE International Workshop on Metrology for Agriculture and Forestry (MetroAgriFor) | 2019 | IEEE Conferences
T. A. A. Ali; V. Choksi; M. B. Potdar | Precision Agriculture Monitoring System Using Green Internet of Things (G-IoT) | https://ieeexplore.ieee.org/stamp/stamp.jsp?arnumber=8553866 |  | 2018 2nd International Conference on Trends in Electronics and Informatics (ICOEI) | 2018 | IEEE Conferences
T. C. J. Jeaunita; V. Sarasvathi; M. S. Harsha; B. M. Bhavani; T. Kavyashree | An automated greenhouse system using agricultural Internet of Things for better crop yield | https://ieeexplore.ieee.org/stamp/stamp.jsp?arnumber=8643194 |  | Smart Cities Symposium 2018 | 2018 | IET Conferences
V. Maraš; T. Popović; S. Gajinov; M. Mugoša; V. Popović; A. Savović; K. Pavićević; V. Mirović | Optimal Irrigation as a tool of Precision Agriculture | https://ieeexplore.ieee.org/stamp/stamp.jsp?arnumber=8760145 |  | 2019 8th Mediterranean Conference on Embedded Computing (MECO) | 2019 | IEEE Conferences
M. Ji; J. Yoon; J. Choo; M. Jang; A. Smith | LoRa-based Visual Monitoring Scheme for Agriculture IoT | https://ieeexplore.ieee.org/stamp/stamp.jsp?arnumber=8706100 | yes | 2019 IEEE Sensors Applications Symposium (SAS) | 2019 | IEEE Conferences
A. N. Harun; M. R. M. Kassim; I. Mat; S. S. Ramli | Precision irrigation using Wireless Sensor Network | https://ieeexplore.ieee.org/stamp/stamp.jsp?arnumber=7322513 |  | 2015 International Conference on Smart Sensors and Application (ICSSA) | 2015 | IEEE Conferences
G. Marques; R. Pitarma | Agricultural environment monitoring system using wireless sensor networks and IoT | https://ieeexplore.ieee.org/stamp/stamp.jsp?arnumber=8399320 |  | 2018 13th Iberian Conference on Information Systems and Technologies (CISTI) | 2018 | IEEE Conferences
K. Tsai; Y. Huang; F. Leu; I. You; Y. Huang; C. Tsai | AES-128 Based Secure Low Power Communication for LoRaWAN IoT Environments | https://ieeexplore.ieee.org/stamp/stamp.jsp?arnumber=8404071 | yes | IEEE Access | 2018 | IEEE Journals
L. Zhu; P. Chen | A Compact, Zero-Power and Low-Noise Harmonic-Transponder for Liquid and Moisture Sensing | https://ieeexplore.ieee.org/stamp/stamp.jsp?arnumber=8888609 |  | 2019 IEEE International Symposium on Antennas and Propagation and USNC-URSI Radio Science Meeting | 2019 | IEEE Conferences
A. A. ElSabaa; M. Ward; W. Wu | Hybrid Localization techniques in LoRa-based WSN | https://ieeexplore.ieee.org/stamp/stamp.jsp?arnumber=8895196 | yes | 2019 25th International Conference on Automation and Computing (ICAC) | 2019 | IEEE Conferences
O. Debauche; M. El Moulat; S. Mahmoudi; P. Manneback; F. Lebeau | Irrigation pivot-center connected at low cost for the reduction of crop water requirements | https://ieeexplore.ieee.org/stamp/stamp.jsp?arnumber=8360259 |  | 2018 International Conference on Advanced Communication Technologies and Networking (CommNet) | 2018 | IEEE Conferences
Z. Li; J. Wang; R. Higgs; L. Zhou; W. Yuan | Design of an Intelligent Management System for Agricultural Greenhouses Based on the Internet of Things | https://ieeexplore.ieee.org/stamp/stamp.jsp?arnumber=8005989 |  | 2017 IEEE International Conference on Computational Science and Engineering (CSE) and IEEE International Conference on Embedded and Ubiquitous Computing (EUC) | 2017 | IEEE Conferences
M. Mancini; P. Nassisi; A. Trabucco; A. Meloni; K. Toli; V. Bacciu; G. Aloisio; D. Spano; S. Mereu | An Open Source and Low-Cost Internet of Things-enabled Service for Irrigation Management | https://ieeexplore.ieee.org/stamp/stamp.jsp?arnumber=8914230 |  | 2019 IEEE International Conference on Systems, Man and Cybernetics (SMC) | 2019 | IEEE Conferences
