dlgur1994/Purdue2019/Records/Testing/10_23.docx

APRS

-15dBm(0.03162mW)

30dB(x10x10x10)

—> 31.62mW

Voltage: 5v(assumption)

Current: 6.324mA

LoRa

-18dBm(0.01585mW)

30dB

—>15.85mW

Voltage: 5v(assumption)

Current: 3.17mA
