dlgur1994/Purdue2019/Records/Testing/11_5.docx

with transistor, auttenuator: -10dbm, -29dbm

without transistor, auttenuator: -15dbm, -27dbm
