dlgur1994/Purdue2019/Records/Testing/0927_Farm/APRS_distance_test.xlsx

Location | Latitude(N) | Longitude(W) | Distacne(km) | Signal Strength(dbm) | Etc | LoRa
Base Station | 40.474743 | 86.991422
Test1 | 40.4746509 | 86.9933091 | 0.16 | -50 | Success | Success
Test2 | 40.4758195 | 87.0006282 | 0.8 | -80 | Success | Fail
Test3 | 40.4795891 | 87.0007576 | 1 | -80~90 | Success | Fail
Test4 | 40.4828732 | 87.0008726 | 1.2 | -90 | not continuously | Fail
Test5 | 40.48546 | 87.000967 | 1.5 | XXX | Fail | Fail
