dlgur1994/Purdue2019/Records/Testing/1001_Ksq/APRS_distance_test_1001.xlsx

Location | Latitude(N) | Longitude(W)
Base1 | 40.4239982 | 86.9128474 | From | To | Distance | Etc
Base2 | 40.4237002 | 86.9081284 | Base1 | Test1 | 1.3 | Success
Test1 | 40.4242802 | 86.9277034 | Base1 | Test2 | 2.3 | Success
Test2 | 40.4242294 | 86.940556 | Base2 | Test2 | 2.8 | Success
