dlgur1994/Purdue2019/Records/Testing/1017_Ksq/APRS_distance_test_1017.xlsx

Location | Latitude(N) | Longitude(W) | Distacne(km) | Signal Strength(dbm) | Etc
Base Station | 40.4296459 | 86.9560327
Test1 | 40.4243893 | 86.9324752,17 | 1.7 | -85~90 | Success
Test2 | 40.4347418 | 86.9643582 | 2.6 | -70 | Success
Test3 | 40.4221111 | 86.9530167 | 3.4 | -70 | Success
Test4 | 40.4347418 | 86.9643582 | 4.2 | -90 | not continuously
Test5 | 40.4347418 | 86.9643582 | 5 | -80~90 | Success
Test6 | 40.4347418 | 86.9643582 | 6.7 | -90 | Success
