dlgur1994/Purdue2019/Records/Testing/1106_Farm/1106Farm_distance_test.xlsx

Location | Latitude(N) | Longitude(W) | Distacne(km) | APRS | LoRa
Base Station | 40.474743 | 86.991422
Test1 | 40.479621 | 86.993666 | 0.7km | Success | Success
Test2 | 40.4758195 | 87.0006282 | 1.3km | Fail | Success
Test3 | 40.5045906 | 86.9651982 | 4.2km | Fail | Success
Test4 | 40.5045001 | 86.9535226 | 4.9km | Fail | Fail
Test5
