dlgur1994/Purdue2019/Records/Testing/1207_Farm/APRS_distance_test_0927.xlsx

Location | Latitude(N) | Longitude(W) | Distacne(km) | Signal Strength(dbm) | Etc
Base Station | 40.474743 | 86.991422
Test1 | 40.4744415 | 87.0013869 | 0.65 | -85 | Success
Test2 | 40.4760439 | 87.003023 | 0.78 | -90~95 | Success
Test3 | 40.4795939 | 87.0031119 | 0.94 | -100 | Fail
Test4 | 40.4781474 | 87.0030707 | 0.86 | -95 | Fail
Test5 | 40.4773724 | 87.0030512 | 0.83 | -90 | Success
Test6 | 40.4776236 | 87.0030589 | 0.84 | -90 | Success
