dlgur1994/Purdue2019/LoRa/Distance Test/LoRa Diagram.png

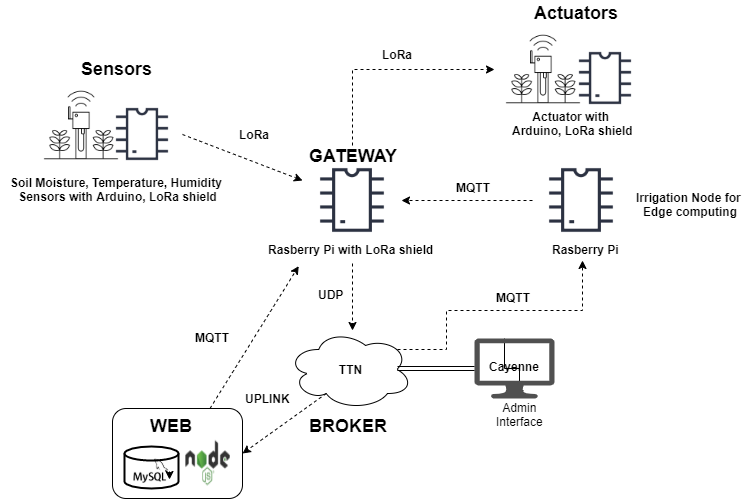
LoRa/Distance Test/LoRa Diagram.png
