dlgur1994/Purdue2019/Records/Testing/0920_Ksq/Screenshot from 2019-09-19 16-06-11.png

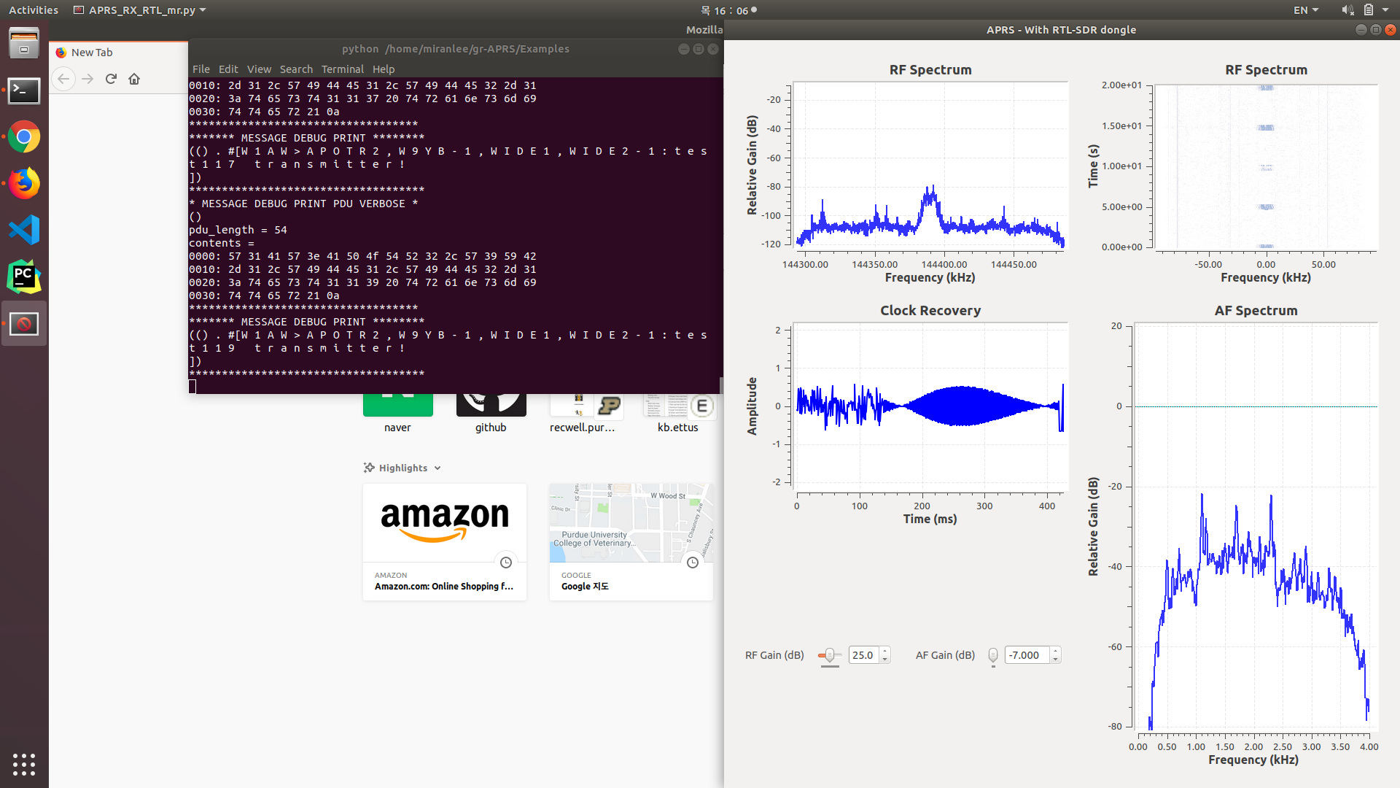
Records/Testing/0920_Ksq/Screenshot from 2019-09-19 16-06-11.png
