dlgur1994/Purdue2019/Records/Testing/0927_Farm/map.png

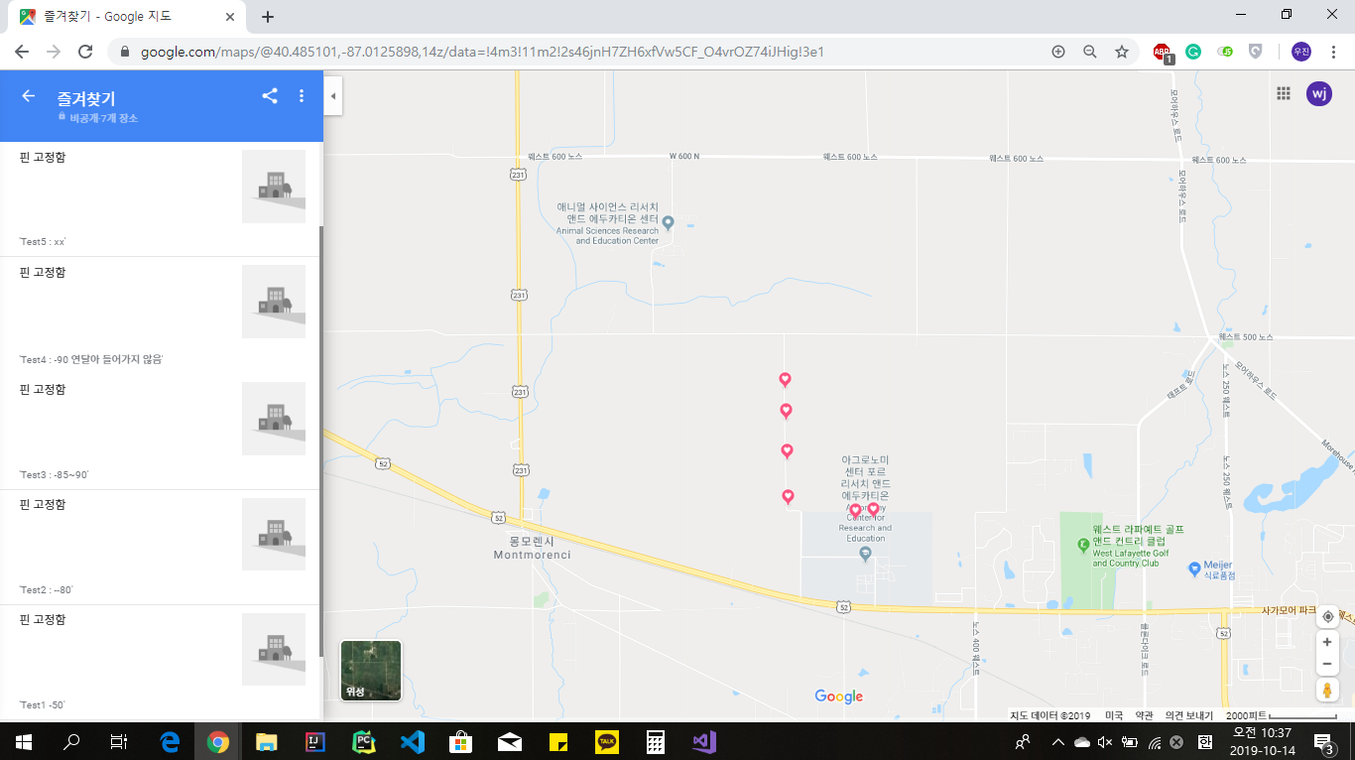
Records/Testing/0927_Farm/map.png
