dlgur1994/Purdue2019/Records/Testing/1001_Ksq/map_1001.png

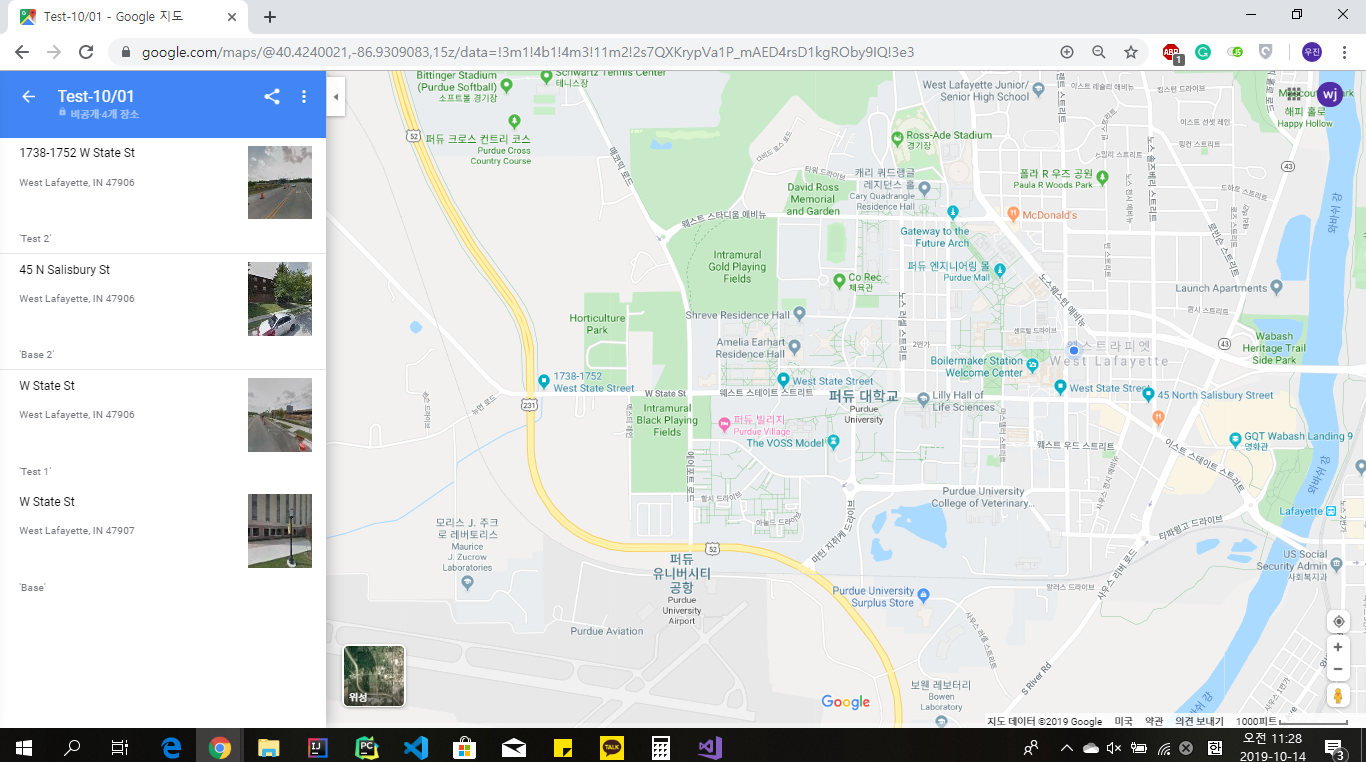
Records/Testing/1001_Ksq/map_1001.png
