dlgur1994/Purdue2019/Records/Testing/1017_Ksq/map1017.png

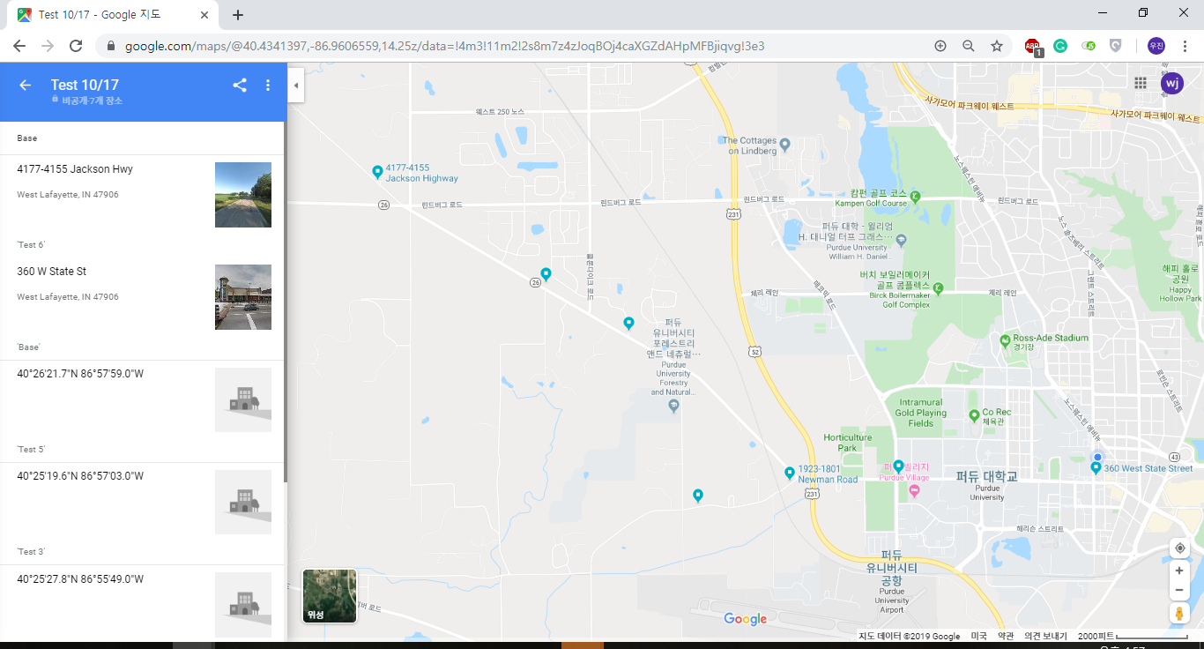
Records/Testing/1017_Ksq/map1017.png
