dlgur1994/Purdue2019/Records/Testing/1106_Farm/Photo/KakaoTalk_20191108_112905200_03.jpg

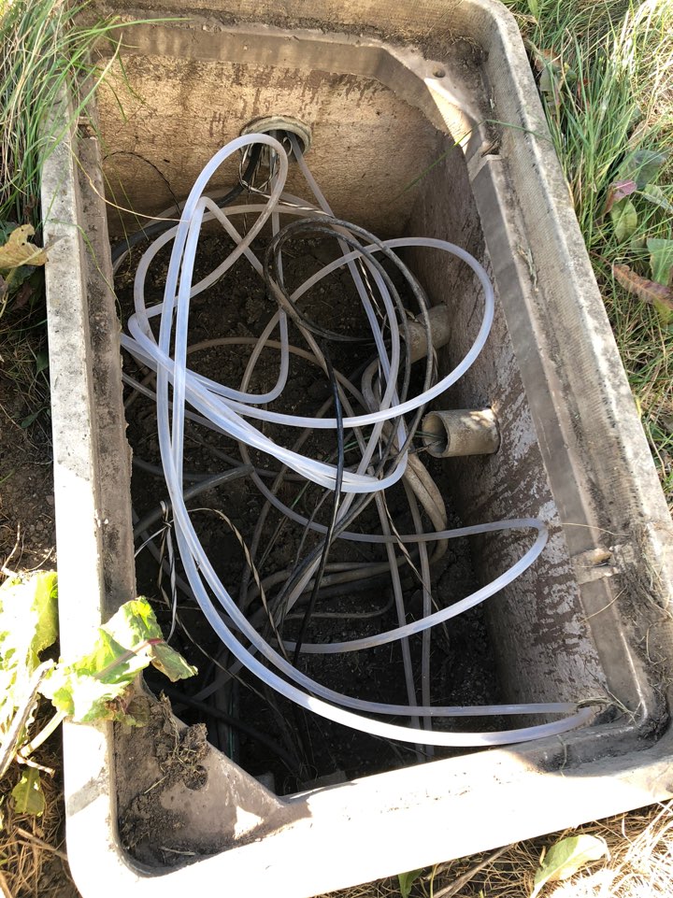
Records/Testing/1106_Farm/Photo/KakaoTalk_20191108_112905200_03.jpg
