dlgur1994/Purdue2019/(list of files, drawings)

Other design files:
Records/solenoid_valve.fzz
