dlgur1994/Purdue2019/LoRa/MQTT/LoRa_RaspiToArduino/LoRa_Reciever/LoRa_Reciever.ino

#include <SPI.h>
#include <LoRa.h>
/*Serial Peripheral Interface (SPI) is a synchronous serial data protocol used by microcontrollers for communicating with one or more peripheral devices quickly over short distances. */
void setup() {
  Serial.begin(9600);
  while (!Serial);
  Serial.println("LoRa Receiver");
  if (!LoRa.begin(915E6)) { /*LoRa.begin(frequency)*/
    Serial.println("Starting LoRa failed!");
    while (1);
  }else{
    LoRa.setTxPower(13);
    LoRa.setSignalBandwidth(125E3);
    LoRa.setCodingRate4(5);

  }
}
void loop() {
  // try to parse packet
  int packetSize = LoRa.parsePacket();
  if (packetSize) {
    // received a packet
    Serial.print("Received packet '");
    // read packet
    while (LoRa.available()) {
      Serial.print((char)LoRa.read());
    }
    // print RSSI of packet
    Serial.print("' with RSSI ");
    Serial.println(LoRa.packetRssi());
  }
}
