dlgur1994/Purdue2019/(commit log)

2020-07-26 google drive folders added
    [1106Farm_distance_test.xlsx, APRS_distance_test.xlsx, APRS_distance_test_0927.xlsx, APRS_distance_test_1001.xlsx, APRS_distance_test_1017.xlsx, LR-거리비교.xlsx, Literature Review Matrix.xlsx, Team 시간표.xlsx]
2020-09-27 mqtt raspberry pieadded
2020-09-27 paper added
    [LR-거리비교.xlsx]
